GingerGengar/Sizing_Algorithm/CAD UPDATE 10-17/Screen Shot 2022-10-03 at 10.49.30 PM.png

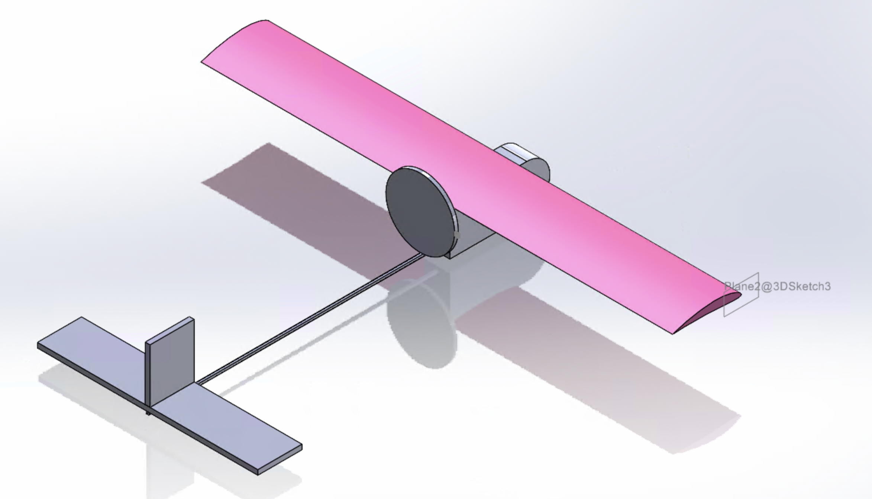
CAD UPDATE 10-17/Screen Shot 2022-10-03 at 10.49.30 PM.png
