GingerGengar/Sizing_Algorithm/CAD Pictures/CG.png

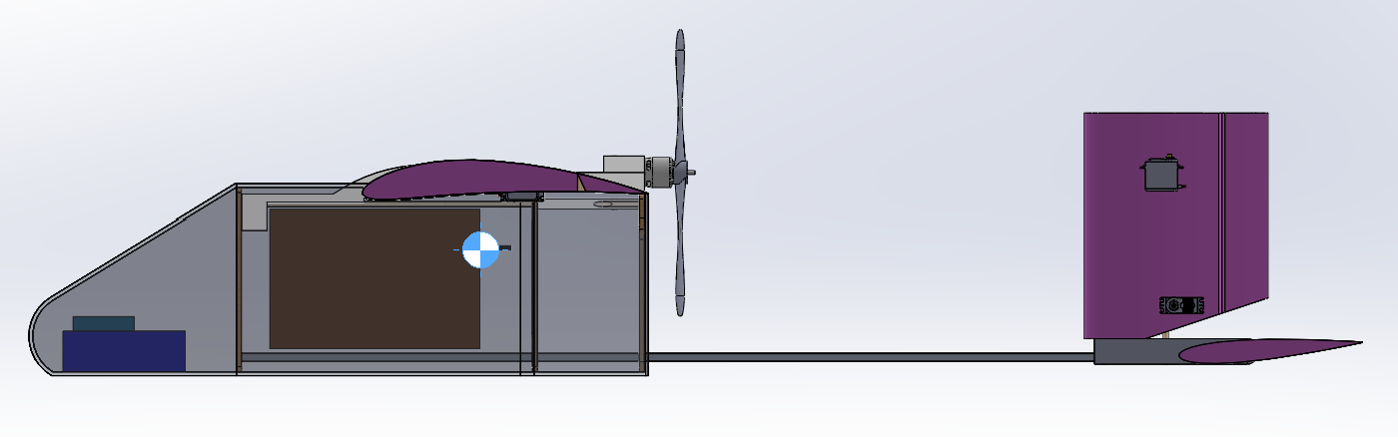
CAD Pictures/CG.png
