GingerGengar/Sizing_Algorithm/README.md

# Purpose of Algorithm

This algorithm is written to estimate the approximate size of an electric vehicle that was tasked of carrying a certain payload.

# Navigating the Code-Base

The Documentation folder contains a PDF document which speaks about the various functionalities and how it intersects well with one another

# Running the Algorithm

This algorithm is mostly written in Matlab. Use Matlab and run it on Main.m . The console and plots appearing are the results of the program.
