GingerGengar/Sizing_Algorithm/Sizing_Algorithm_Code/Documentation/Pre_Amble.tex

\usepackage{amsmath}
\usepackage{esint}
\usepackage{comment}
\usepackage{amssymb}
\usepackage{commath}
\usepackage{geometry}
\usepackage{graphicx}
\usepackage{hyperref}
\usepackage{listings}
\usepackage{xcolor}
\usepackage{array}
\usepackage{float}
\geometry{portrait, margin= 0.5in}
\setcounter{MaxMatrixCols}{30}

\definecolor{codegreen}{rgb}{0,0.6,0}
\definecolor{codegray}{rgb}{0.5,0.5,0.5}
\definecolor{codepurple}{rgb}{0.58,0,0.82}
\definecolor{backcolour}{rgb}{0.95,0.95,0.92}

\lstset{
	columns=fullflexible,
	frame=single,
	breaklines=true,
	backgroundcolor=\color{backcolour},   
	commentstyle=\color{codegreen},
	keywordstyle=\color{magenta},
	numberstyle=\tiny\color{codegray},
	stringstyle=\color{codepurple},
	basicstyle=\ttfamily\footnotesize,
	keepspaces=true,                 
	numbersep=5pt,                  
	showspaces=false,               
	showtabs=false,                  
	tabsize=2
}
