GingerGengar/Sizing_Algorithm/sample_constraint_diagram.png

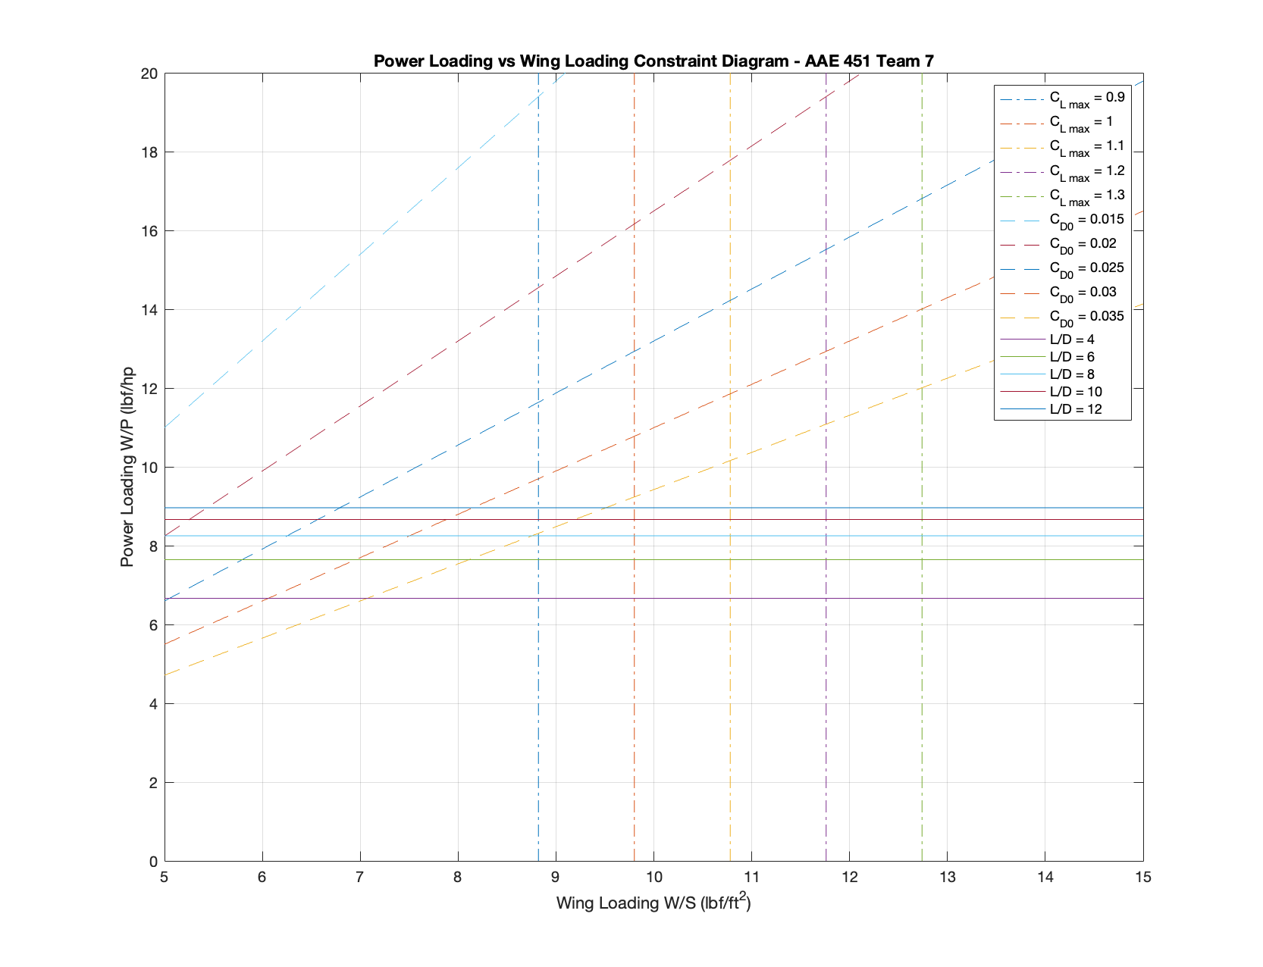
sample_constraint_diagram.png
