GingerGengar/Sizing_Algorithm/CAD UPDATE 10-17/TailAssemblyBetter.SLDASM

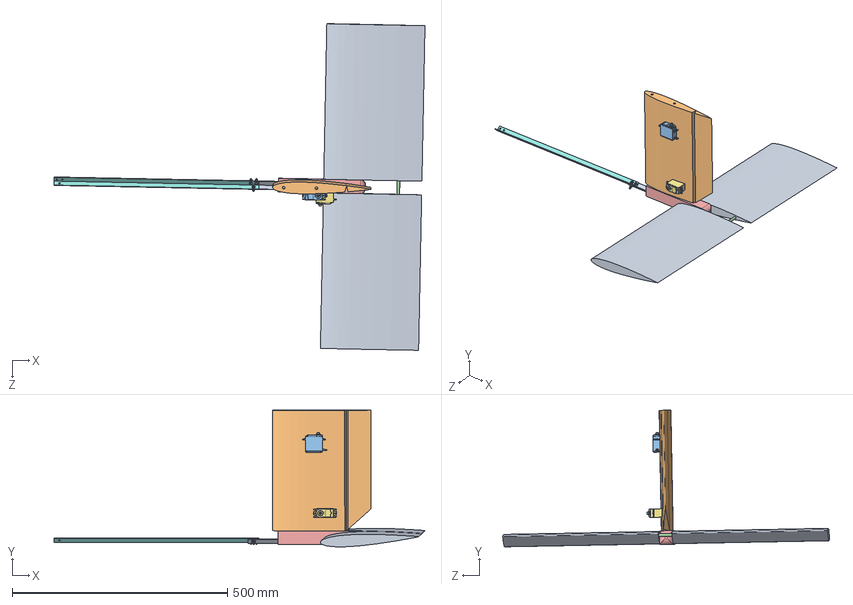
[picture p7: CAD file, 2022-12-03]
CAD UPDATE 10-17/TailAssemblyBetter.SLDASM
861.8 x 317.6 x 758.9 mm
HorizontalTail
VerticalTail
MG995Servo
WoodDowel x 3
TailAdapter
Half_Inch_Spar_CYLINDER_NEW
MG995ServoBig
AngleAluminumMiddle
AngleAluminumEnd
No 8 Pan Head Screw x 3
BoomNut x 3
