GingerGengar/Sizing_Algorithm/CAD UPDATE 10-17/TailAssembly.SLDASM

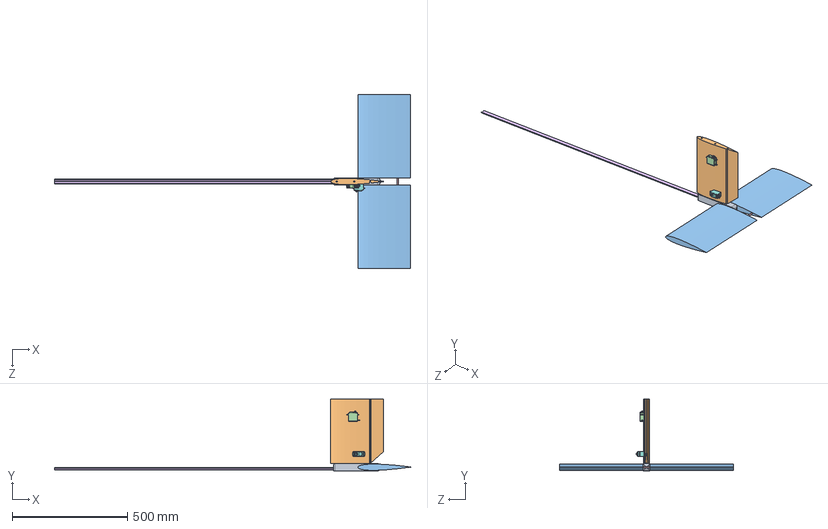
[picture p8: CAD file, 2022-12-03]
CAD UPDATE 10-17/TailAssembly.SLDASM
1546.8 x 311.7 x 754.4 mm
HorizontalTail
VerticalTail
MG995Servo
WoodDowel x 3
AngleAluminum
TailAdapter
Half_Inch_Spar_CYLINDER_NEW
MG995ServoBig
