GingerGengar/Sizing_Algorithm/CAD UPDATE 10-17/StorageAssembly.SLDASM

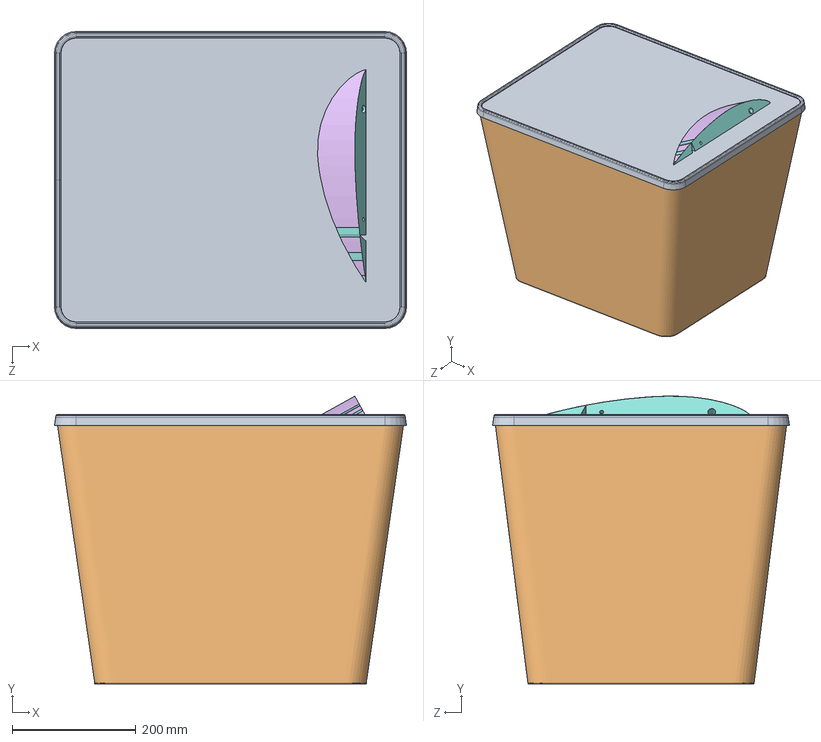
[picture p9: CAD file, 2022-12-03]
CAD UPDATE 10-17/StorageAssembly.SLDASM
568.2 x 464.4 x 479.3 mm
StorageBinBetter
StorageBinLid
BetterWing
WingCenterShell
WingInnerPart x 2
WingOuterShell x 4
WingOuterPart
WingOuterPartLeft
BatteryESCMount
FRONT_WING_MOUNT_NEW
BoomStopper
Motor_Mount_NEW
REAR HARDPOINT
SmallPXMount
TailAdapter
Batt_V1
ESC
Pixhawk_V1
Propellar
Motor
MotorX
FuselageBackRibANGLE_NEW
FuselageFrontRibANGLE_NEW
FuselageMiddleRibANGLE_NEW
HorizontalTailSplit x 2
VerticalTail
WoodDowel x 7
Half_Inch_Spar x 5
AngleAluminumEnd
AngleAluminumFront
AngleAluminumMiddle
FuselageDowel x 2
No 8 Pan Head Screw x 9
BoomNut x 9
NylonBoltHex x 2
NylonNut x 2
