GingerGengar/Sizing_Algorithm/CAD UPDATE 10-17/WingAssembly.SLDASM

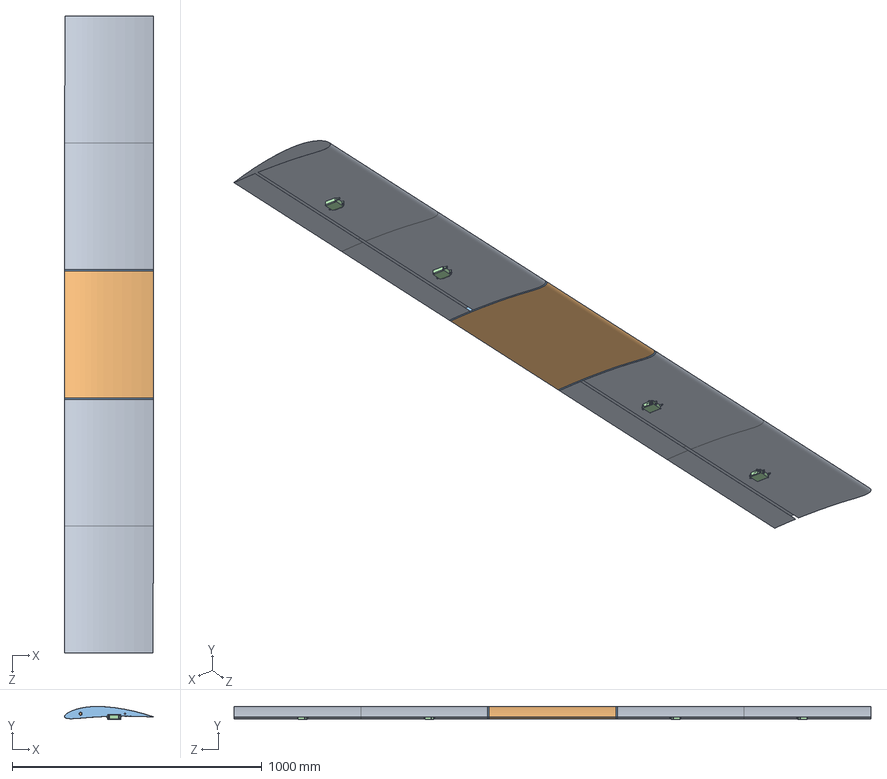
[picture p10: CAD file, 2022-12-03]
CAD UPDATE 10-17/WingAssembly.SLDASM
357.4 x 52.6 x 2552.9 mm
BetterWing
WingConnector x 2
MG995Servo x 4
WingOuterShell x 4
Half_Inch_Spar_CYLINDER_NEW x 4
WoodDowel x 4
