GingerGengar/Sizing_Algorithm/CAD UPDATE 10-17/BatteryRemoval.SLDASM

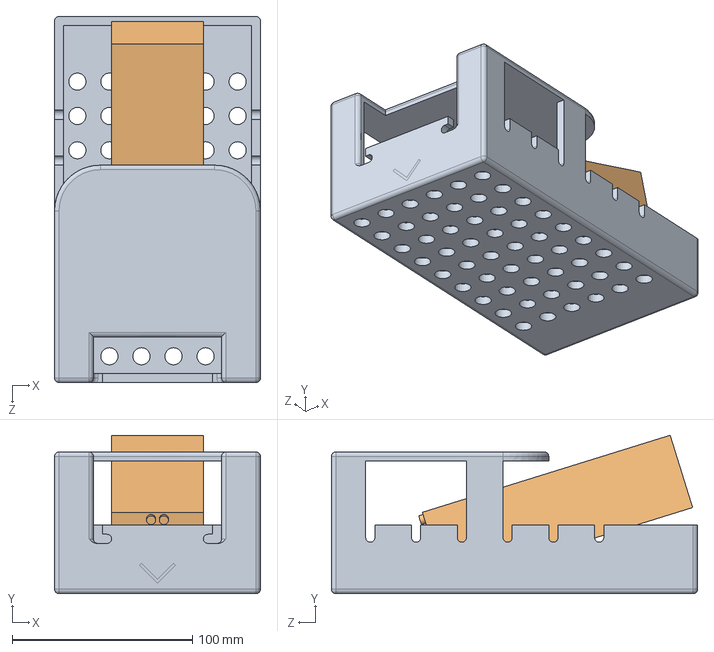
[picture p11: CAD file, 2022-12-03]
CAD UPDATE 10-17/BatteryRemoval.SLDASM
114.3 x 87.9 x 203.2 mm
BatteryESCMount
Batt_V1
