GingerGengar/Sizing_Algorithm/CAD UPDATE 10-17/AssemblyGoCrazy.SLDASM

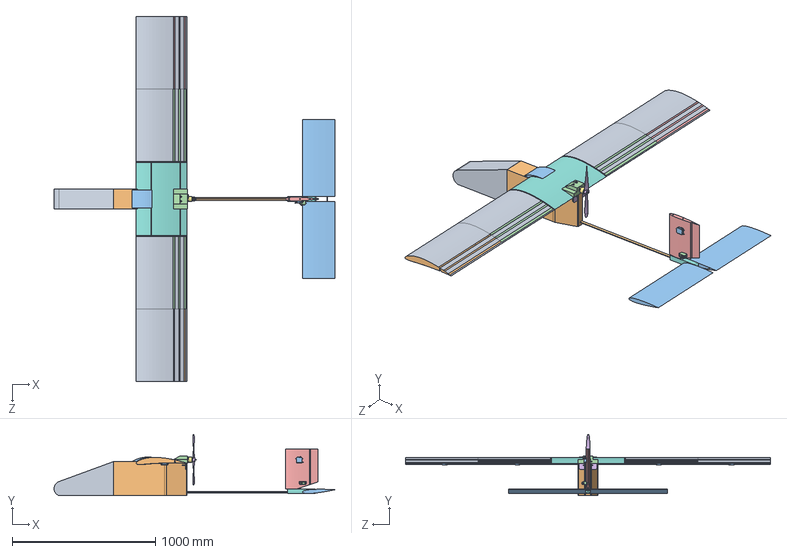
[picture p12: CAD file, 2022-10-29]
CAD UPDATE 10-17/AssemblyGoCrazy.SLDASM
1963.2 x 428.6 x 2552.7 mm
HorizontalTail
FuselageWithWingShape
BetterWing
VerticalTail
Propellar
Motor
Batt_V1
Big_Payload
Pixhawk_V1
MG995Servo x 5
WingInnerPart x 2
WingOuterPart
WingConnector x 2
WoodDowel x 7
WingCenterShell
WingOuterShell x 4
AngleAluminum
FRONT_WING_MOUNT_NEW
Motor_Mount_NEW
REAR HARDPOINT
FuselageBackRibANGLE_NEW
FuselageFrontRibANGLE_NEW
TailAdapter
Half_Inch_Spar_CYLINDER_NEW x 5
WingOuterPartLeft
ESC
MG995ServoBig
FuselageMiddleRibANGLE_NEW
FuselageDowel x 2
CrazyNoze
