GingerGengar/Sizing_Algorithm/CAD UPDATE 10-17/BetterAssembly.SLDASM

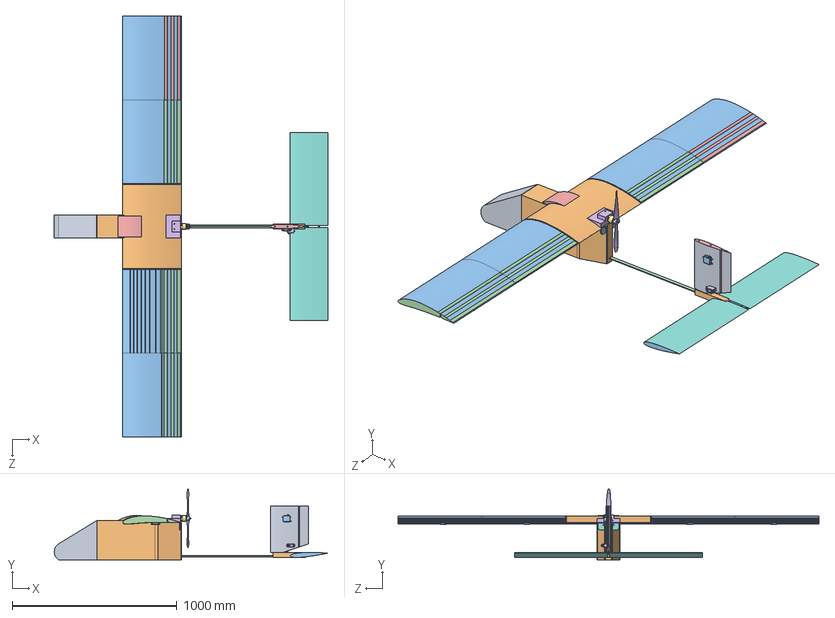
[picture p13: CAD file, 2022-10-26]
CAD UPDATE 10-17/BetterAssembly.SLDASM
1658.7 x 429.7 x 2552.7 mm
HorizontalTail
FuselageWithWingShape
BetterWing
VerticalTail
Propellar
Motor
Batt_V1
Big_Payload
Pixhawk_V1
MG995Servo x 5
WingInnerPart x 2
WingOuterPart
WingConnector x 2
WoodDowel x 7
WingCenterShell
WingOuterShell x 4
AngleAluminum
FRONT_WING_MOUNT_NEW
Motor_Mount_NEW
REAR HARDPOINT
FuselageBackRibANGLE_NEW
FuselageFrontRibANGLE_NEW
TailAdapter
Half_Inch_Spar_CYLINDER_NEW x 5
WingOuterPartLeft
ESC
MG995ServoBig
FuselageMiddleRibANGLE_NEW
NoseCone
