GingerGengar/Sizing_Algorithm/CAD UPDATE 10-17/Assembly.SLDASM

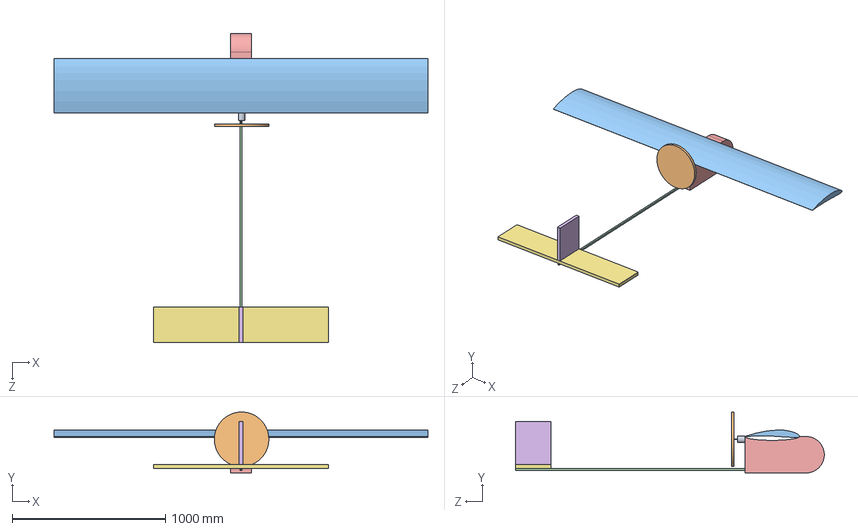
[picture p15: CAD file, 2022-10-04]
CAD UPDATE 10-17/Assembly.SLDASM
2438.4 x 397.4 x 2011.7 mm
Motor_V1
Prop_V1
Wing V1
CF_Rod_V1
Fuselage_V1
Rudder_FlatPlate_V1
Stabilator_FlatPlate_V1
