GingerGengar/Sizing_Algorithm/CAD UPDATE 10-17/Pixhawk_V1.SLDPRT

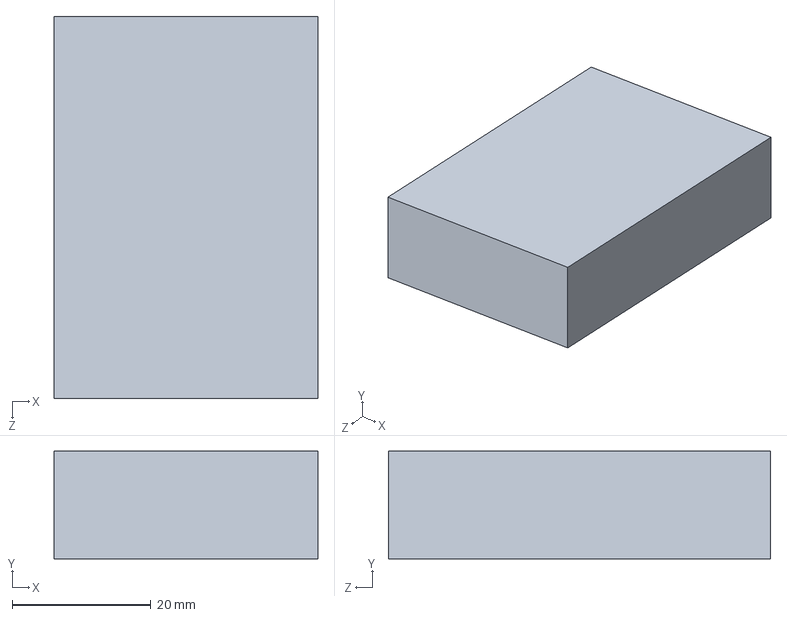
[picture p16: CAD file, 2022-12-03]
CAD UPDATE 10-17/Pixhawk_V1.SLDPRT
38.0 x 15.5 x 55.0 mm
