GingerGengar/Sizing_Algorithm/STL 10-27-22/TailAdapter.STL

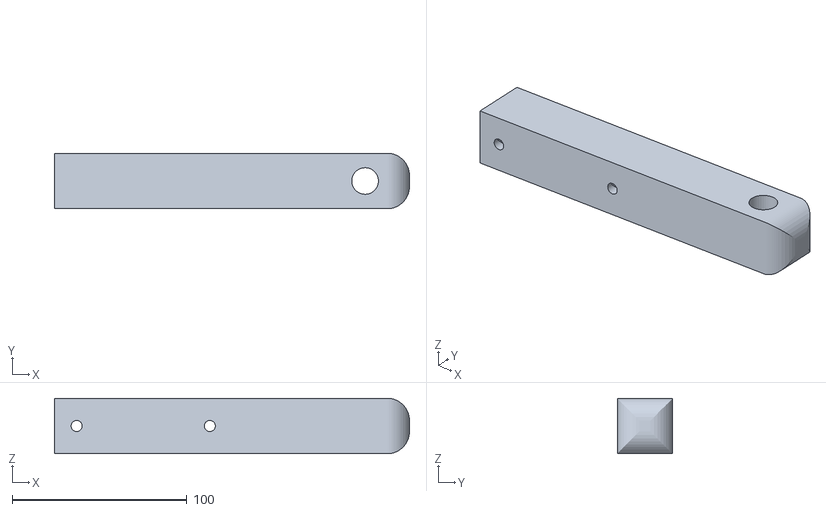
[picture p17: CAD file, 2022-12-03]
STL 10-27-22/TailAdapter.STL
203.2 x 31.8 x 31.8
