GingerGengar/Sizing_Algorithm/STL 11-3-22/FRONT_WING_MOUNT_NEW.STL

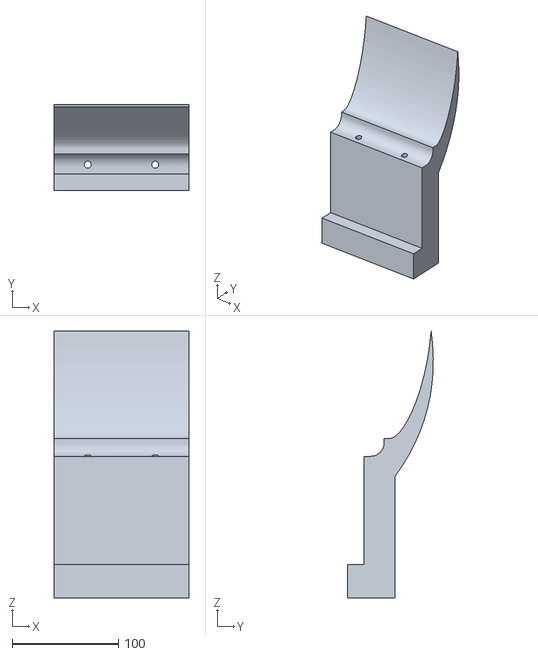
[picture p18: CAD file, 2022-12-03]
STL 11-3-22/FRONT_WING_MOUNT_NEW.STL
127.0 x 80.5 x 251.3
