GingerGengar/Sizing_Algorithm/STL/Half_Inch_Spar_CYLINDER_NEW.STL

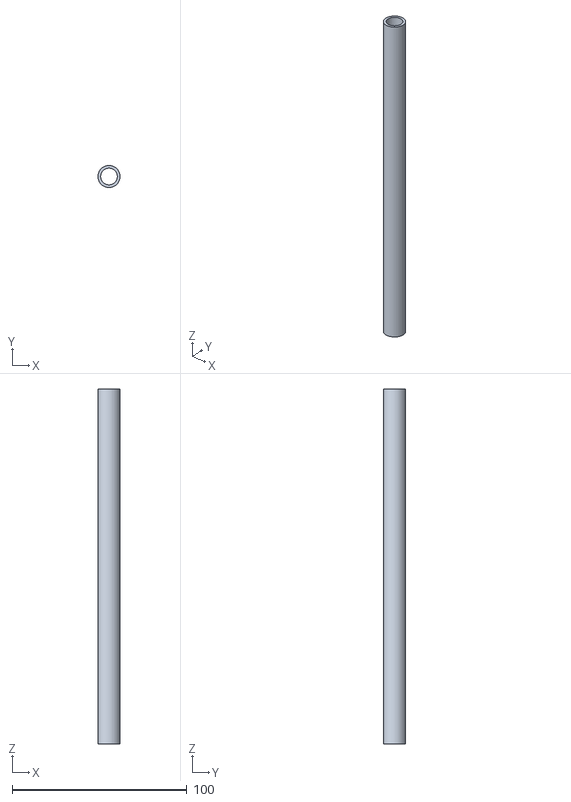
[picture p19: CAD file, 2022-10-18]
STL/Half_Inch_Spar_CYLINDER_NEW.STL
12.7 x 12.7 x 203.2
