GingerGengar/Sizing_Algorithm/STL 10-27-22/BoomStopper.STL

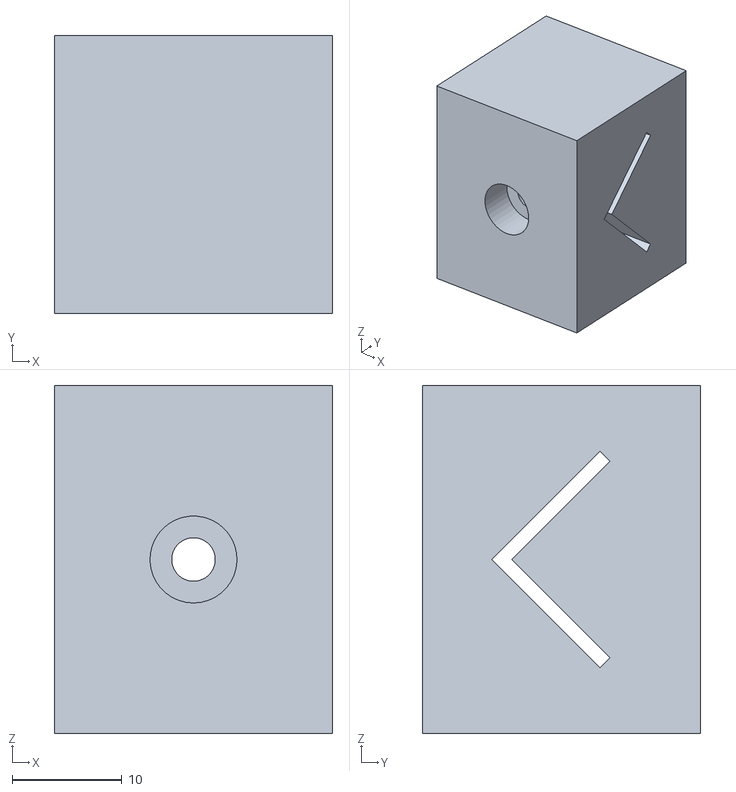
[picture p20: CAD file, 2022-12-03]
STL 10-27-22/BoomStopper.STL
25.4 x 25.4 x 31.8
