GingerGengar/Sizing_Algorithm/STL 11-3-22/SmallPXMount_TOLERANCE.STL

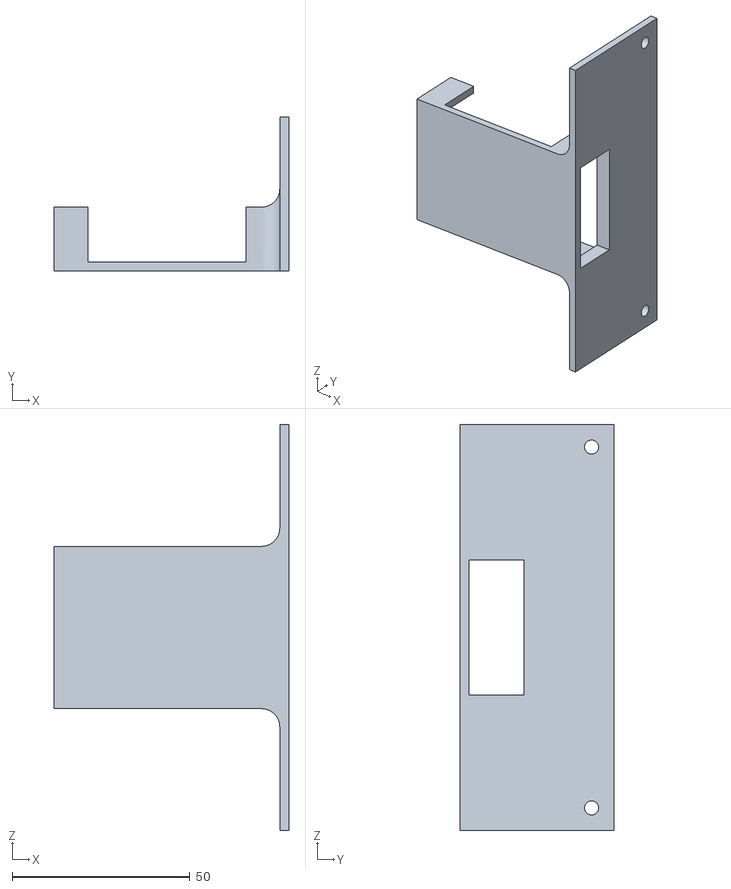
[picture p21: CAD file, 2022-12-03]
STL 11-3-22/SmallPXMount_TOLERANCE.STL
66.0 x 43.4 x 114.3
