GingerGengar/Sizing_Algorithm/CAD UPDATE 10-17/BigPXMount.SLDPRT

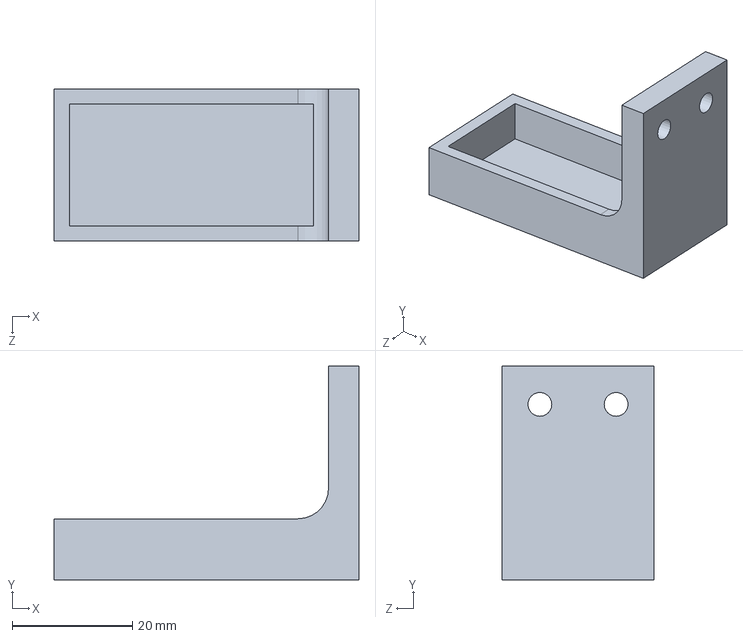
[picture p22: CAD file, 2022-12-03]
CAD UPDATE 10-17/BigPXMount.SLDPRT
50.8 x 35.6 x 25.4 mm
