GingerGengar/Sizing_Algorithm/STL 10-27-22/BatteryESCMount.STL

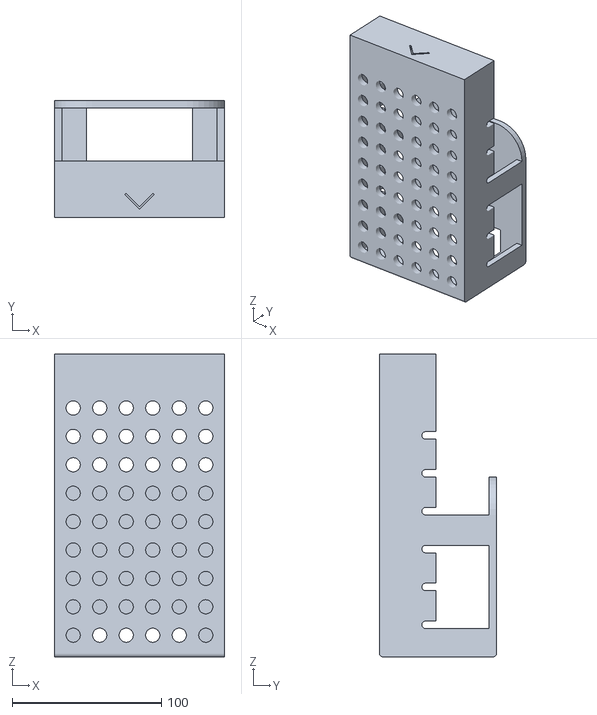
[picture p23: CAD file, 2022-12-03]
STL 10-27-22/BatteryESCMount.STL
114.3 x 78.7 x 203.2
