GingerGengar/Sizing_Algorithm/STL 11-3-22/SmallPXMount.STL

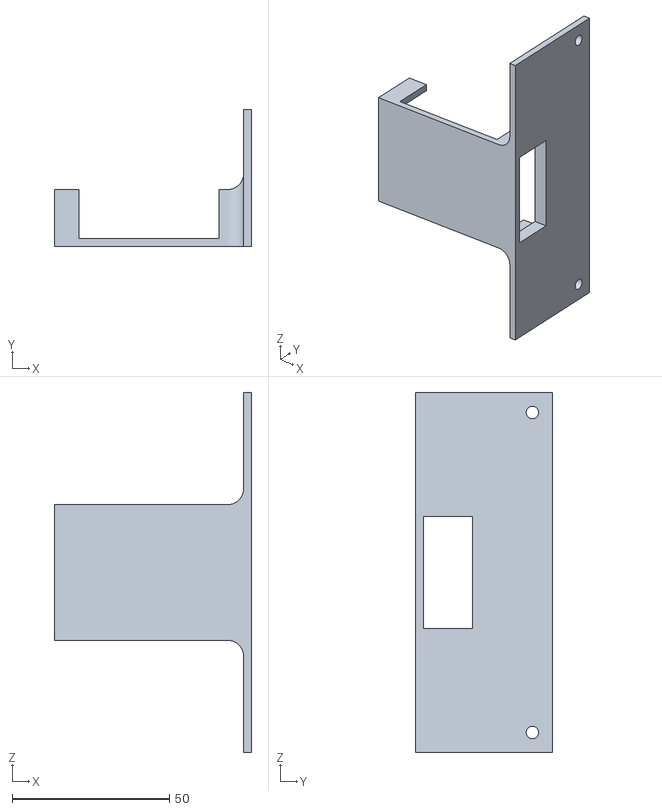
[picture p24: CAD file, 2022-12-03]
STL 11-3-22/SmallPXMount.STL
62.6 x 43.4 x 114.3
