GingerGengar/Sizing_Algorithm/CAD UPDATE 10-17/WingOuterShell.SLDPRT

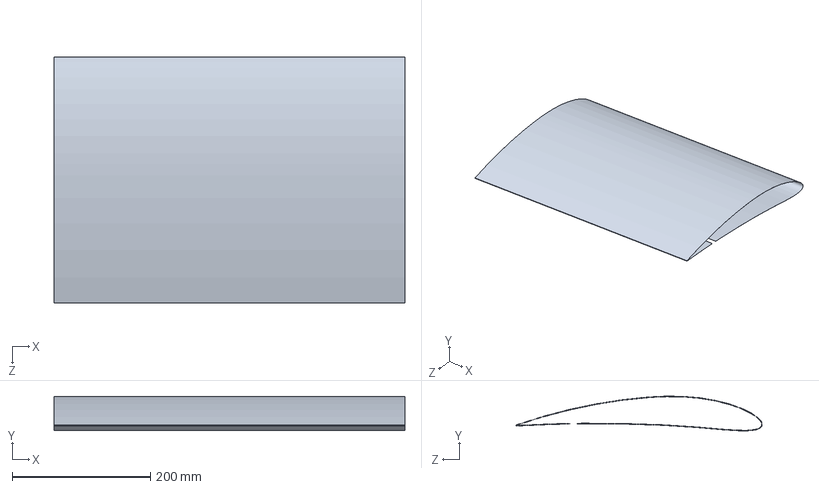
[picture p25: CAD file, 2022-12-03]
CAD UPDATE 10-17/WingOuterShell.SLDPRT
508.0 x 49.4 x 355.9 mm
