GingerGengar/Sizing_Algorithm/STL 11-3-22/Motor_Mount_NEW.STL

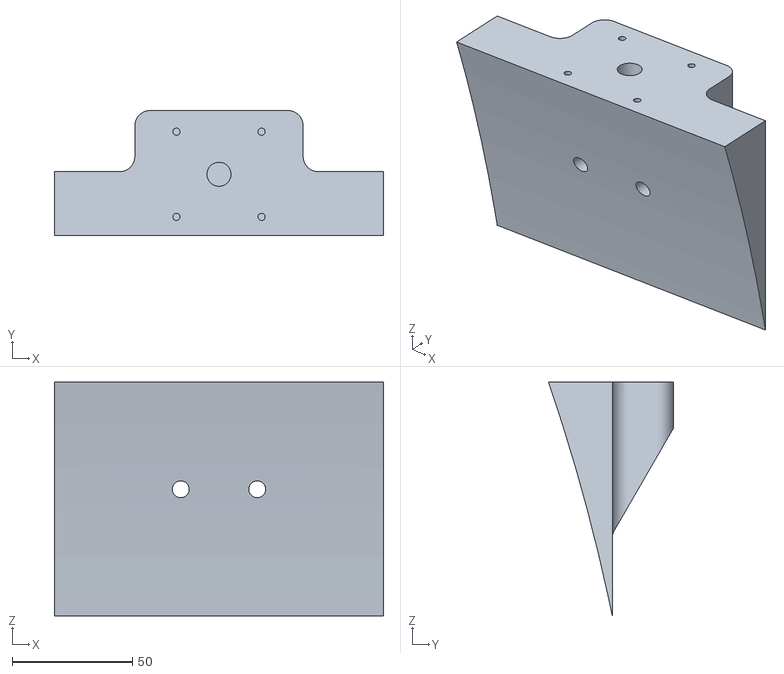
[picture p26: CAD file, 2022-12-03]
STL 11-3-22/Motor_Mount_NEW.STL
136.5 x 51.9 x 96.9
