GingerGengar/Sizing_Algorithm/CAD UPDATE 10-17/XT60 FEMALE.SLDPRT

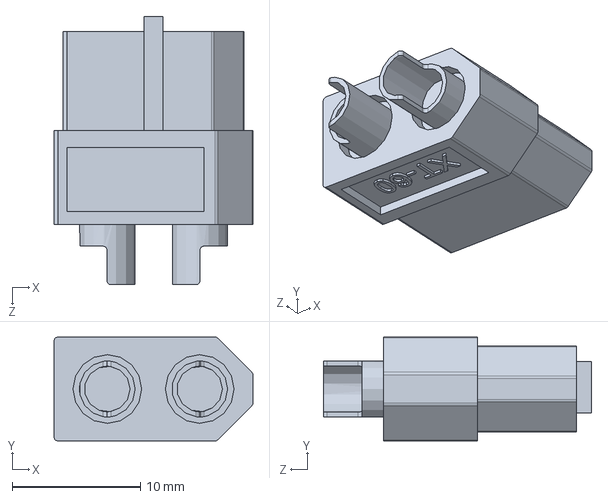
[picture p27: CAD file, 2022-12-03]
CAD UPDATE 10-17/XT60 FEMALE.SLDPRT
15.5 x 8.10 x 20.9 mm
