GingerGengar/Sizing_Algorithm/CAD UPDATE 10-17/MotorX.SLDPRT

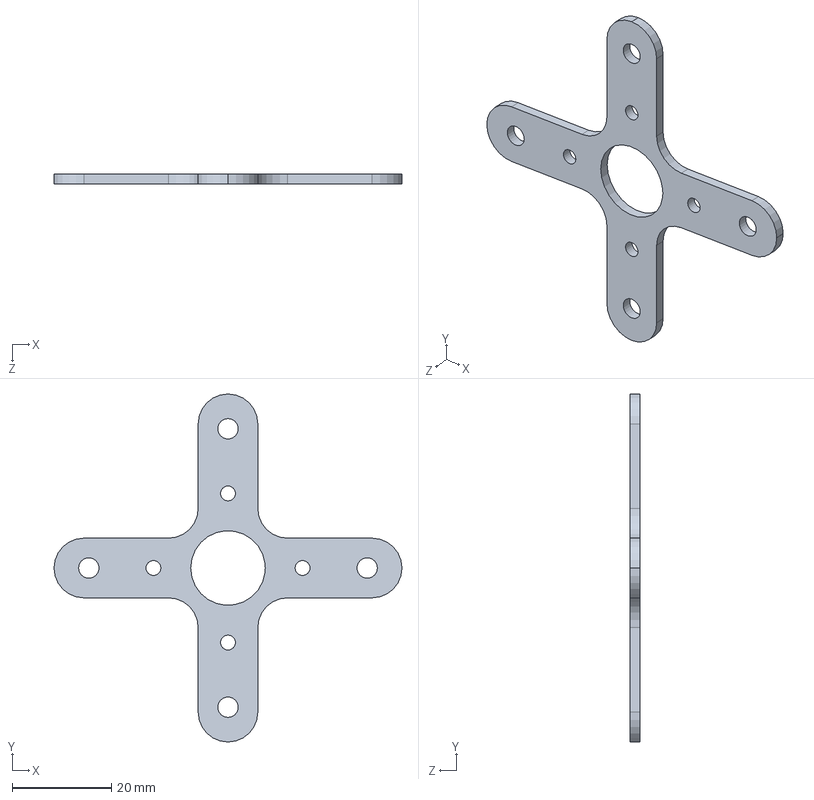
[picture p28: CAD file, 2022-12-03]
CAD UPDATE 10-17/MotorX.SLDPRT
70.0 x 70.0 x 2.00 mm
