GingerGengar/Sizing_Algorithm/STL 10-27-22/Motor_Mount_NEW.STL

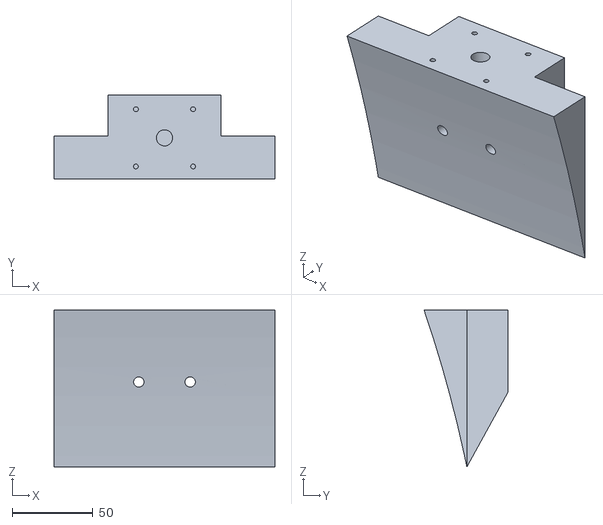
[picture p29: CAD file, 2022-10-29]
STL 10-27-22/Motor_Mount_NEW.STL
136.5 x 51.9 x 96.9
