GingerGengar/Sizing_Algorithm/STL 11-3-22/REAR HARDPOINT.STL

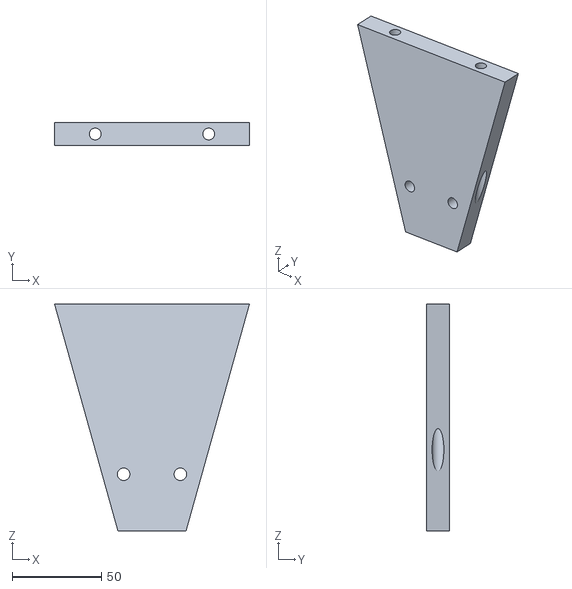
[picture p30: CAD file, 2022-12-03]
STL 11-3-22/REAR HARDPOINT.STL
109.1 x 12.7 x 127.0
