GingerGengar/Sizing_Algorithm/CAD UPDATE 10-17/StorageBinLid.SLDPRT

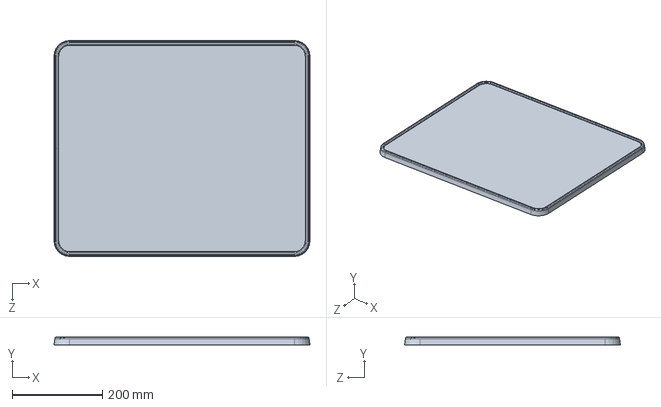
[picture p31: CAD file, 2022-12-03]
CAD UPDATE 10-17/StorageBinLid.SLDPRT
568.2 x 17.8 x 479.3 mm
