GingerGengar/Sizing_Algorithm/STL 11-3-22/BoomStopper.STL

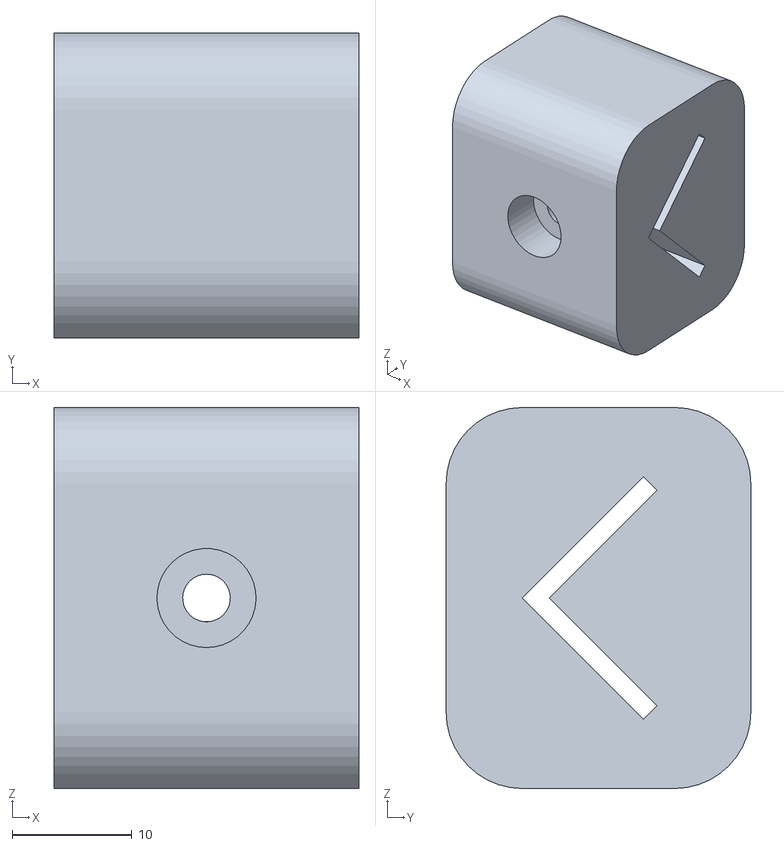
[picture p32: CAD file, 2022-12-03]
STL 11-3-22/BoomStopper.STL
25.4 x 25.4 x 31.8
