GingerGengar/Sizing_Algorithm/CAD UPDATE 10-17/NoseCone.SLDPRT

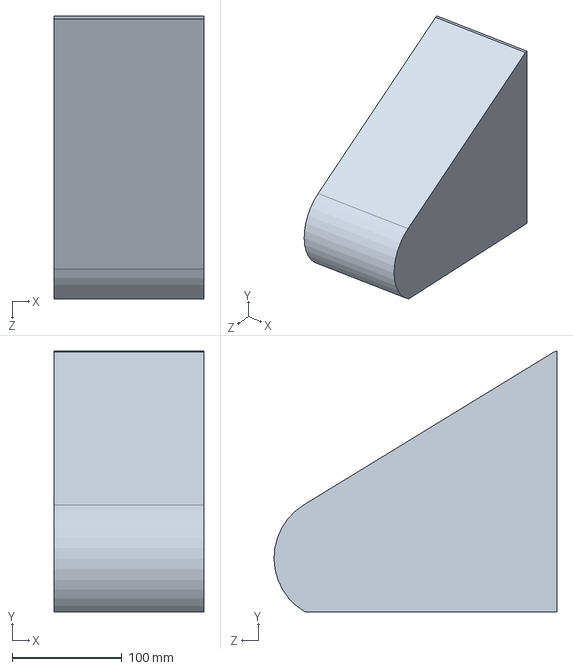
[picture p33: CAD file, 2022-12-03]
CAD UPDATE 10-17/NoseCone.SLDPRT
136.7 x 238.3 x 258.4 mm
