GingerGengar/Sizing_Algorithm/CAD UPDATE 10-17/Motor.SLDPRT

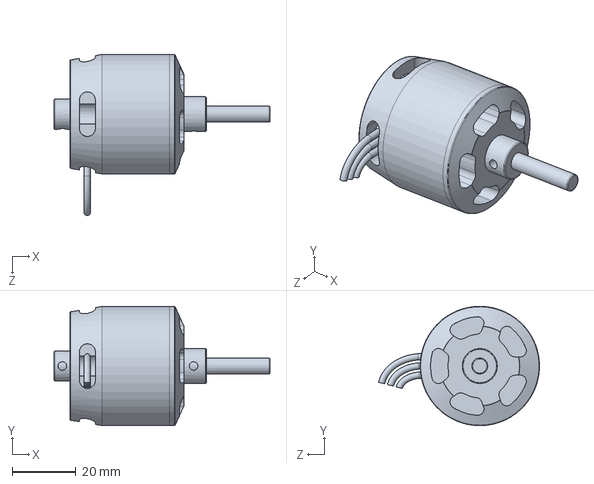
[picture p34: CAD file, 2022-12-03]
CAD UPDATE 10-17/Motor.SLDPRT
67.8 x 37.5 x 50.6 mm
