GingerGengar/Sizing_Algorithm/CAD UPDATE 10-17/FRONT_WING_MOUNT_NEW.SLDPRT

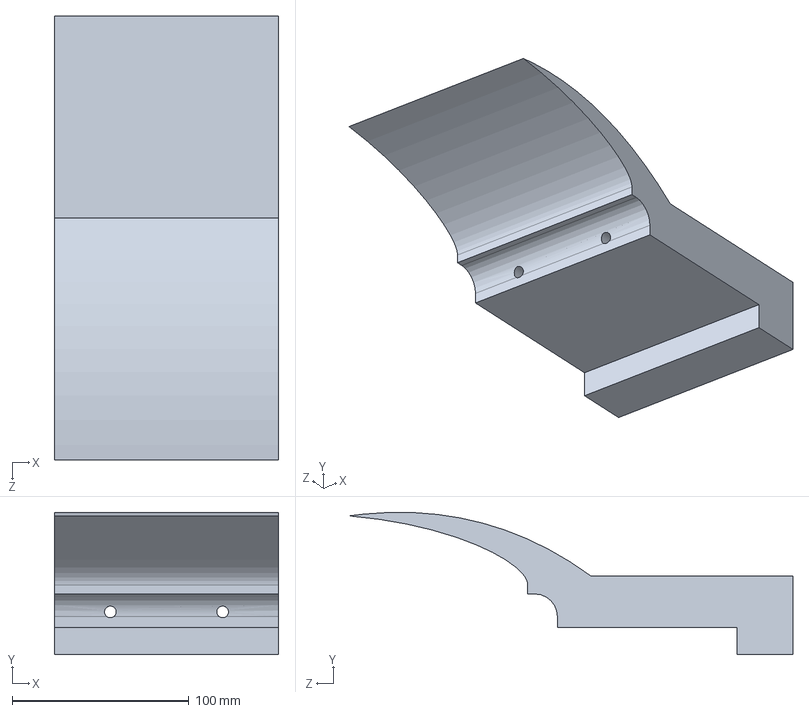
[picture p35: CAD file, 2022-12-03]
CAD UPDATE 10-17/FRONT_WING_MOUNT_NEW.SLDPRT
127.0 x 80.4 x 251.3 mm
