GingerGengar/Sizing_Algorithm/CAD UPDATE 10-17/ESC.SLDPRT

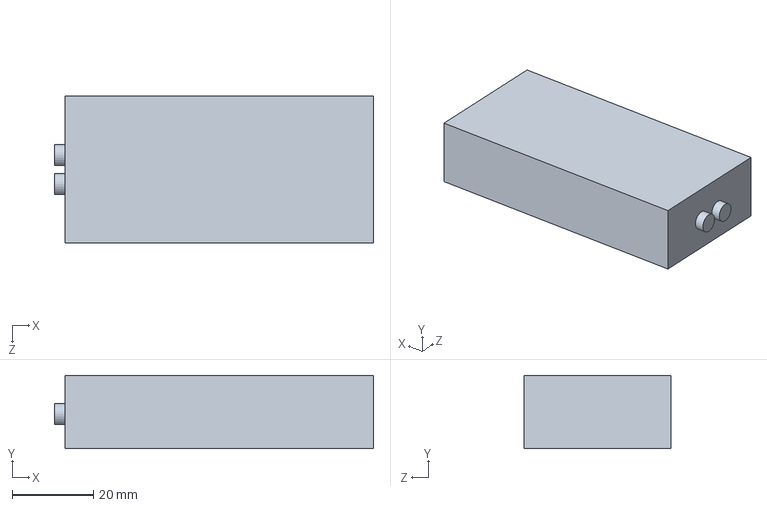
[picture p36: CAD file, 2022-12-03]
CAD UPDATE 10-17/ESC.SLDPRT
78.5 x 18.0 x 36.1 mm
