GingerGengar/Sizing_Algorithm/CAD UPDATE 10-17/Batt_V1.SLDPRT

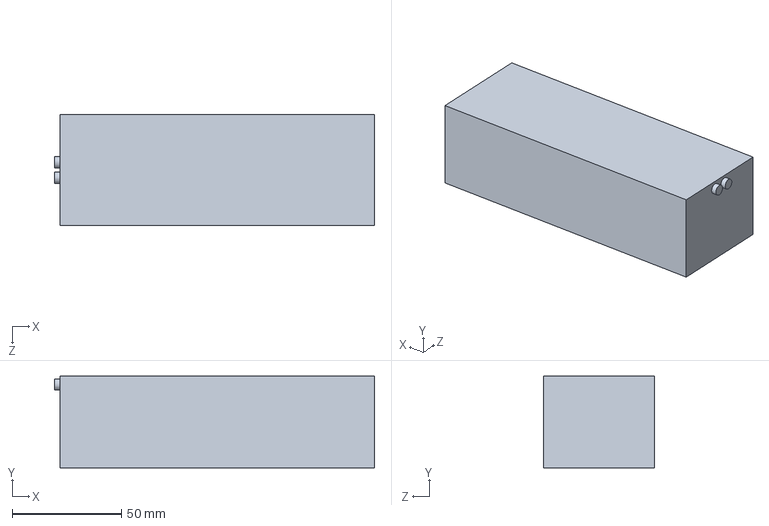
[picture p37: CAD file, 2022-12-03]
CAD UPDATE 10-17/Batt_V1.SLDPRT
146.5 x 42.0 x 51.0 mm
