GingerGengar/Sizing_Algorithm/CAD UPDATE 10-17/FuselageMiddleRibANGLE_NEW.SLDPRT

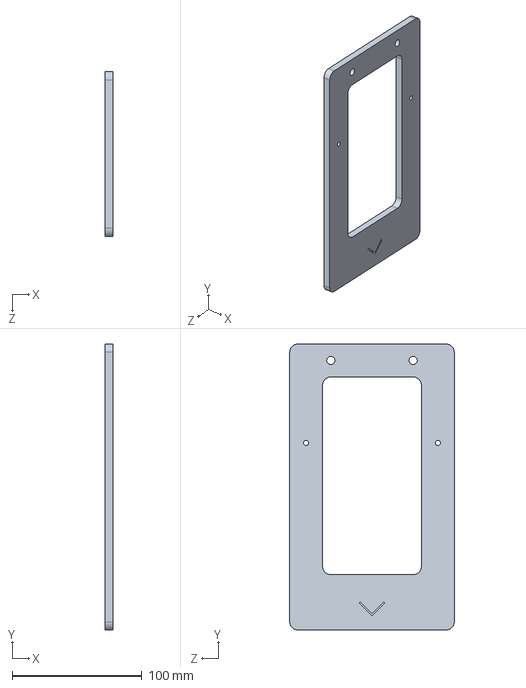
[picture p38: CAD file, 2022-12-03]
CAD UPDATE 10-17/FuselageMiddleRibANGLE_NEW.SLDPRT
6.35 x 220.5 x 127.0 mm
