GingerGengar/Sizing_Algorithm/CAD UPDATE 10-17/FuselageFrontRibANGLE_NEW.SLDPRT

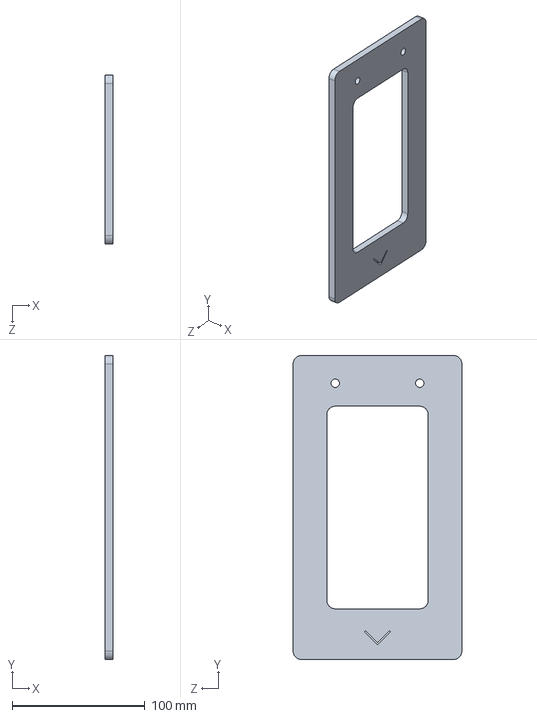
[picture p39: CAD file, 2022-12-03]
CAD UPDATE 10-17/FuselageFrontRibANGLE_NEW.SLDPRT
6.35 x 228.6 x 127.0 mm
