GingerGengar/Sizing_Algorithm/CAD UPDATE 10-17/StorageBin.SLDPRT

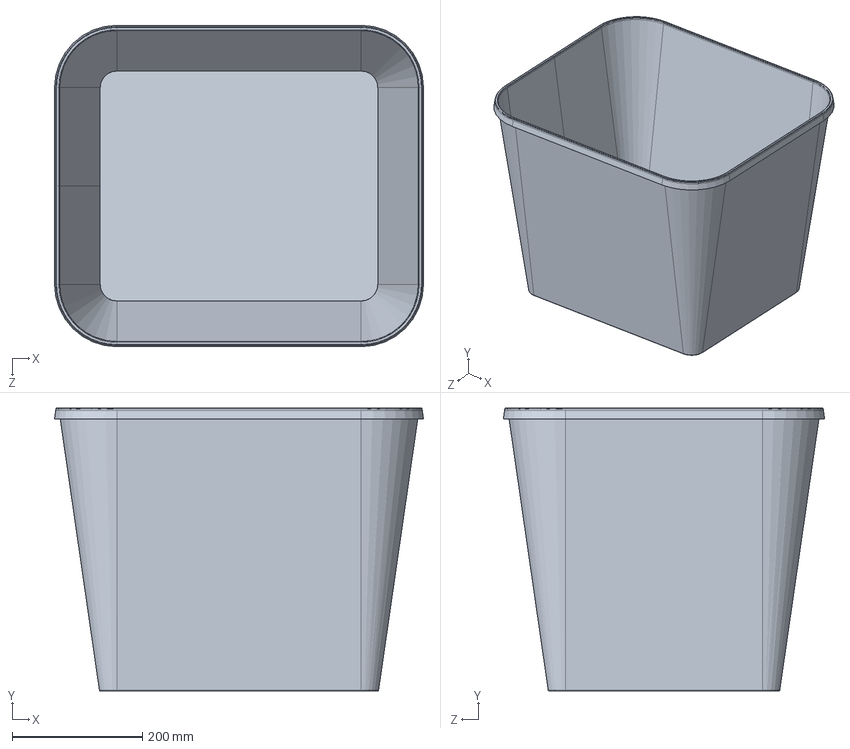
[picture p40: CAD file, 2022-12-03]
CAD UPDATE 10-17/StorageBin.SLDPRT
565.6 x 433.7 x 492.6 mm
