GingerGengar/Sizing_Algorithm/CAD UPDATE 10-17/FuselageDoor.SLDPRT

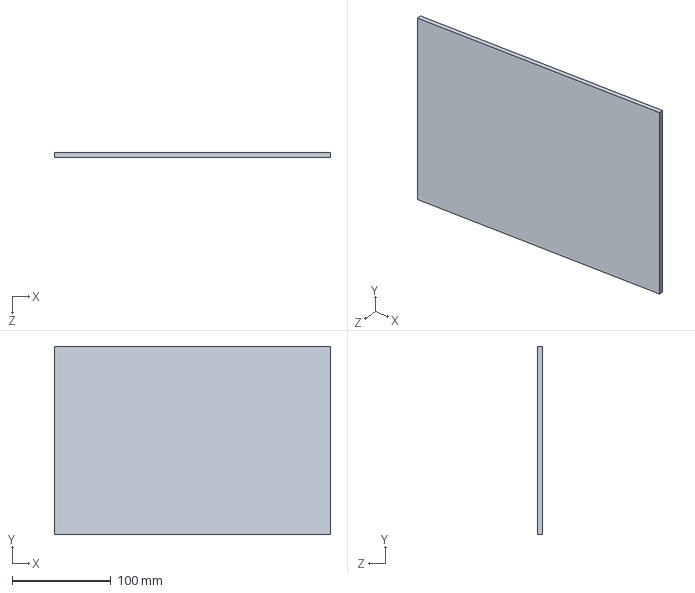
[picture p41: CAD file, 2022-12-03]
CAD UPDATE 10-17/FuselageDoor.SLDPRT
279.4 x 190.5 x 4.83 mm
