GingerGengar/Sizing_Algorithm/CAD UPDATE 10-17/AngleAluminumEnd.SLDPRT

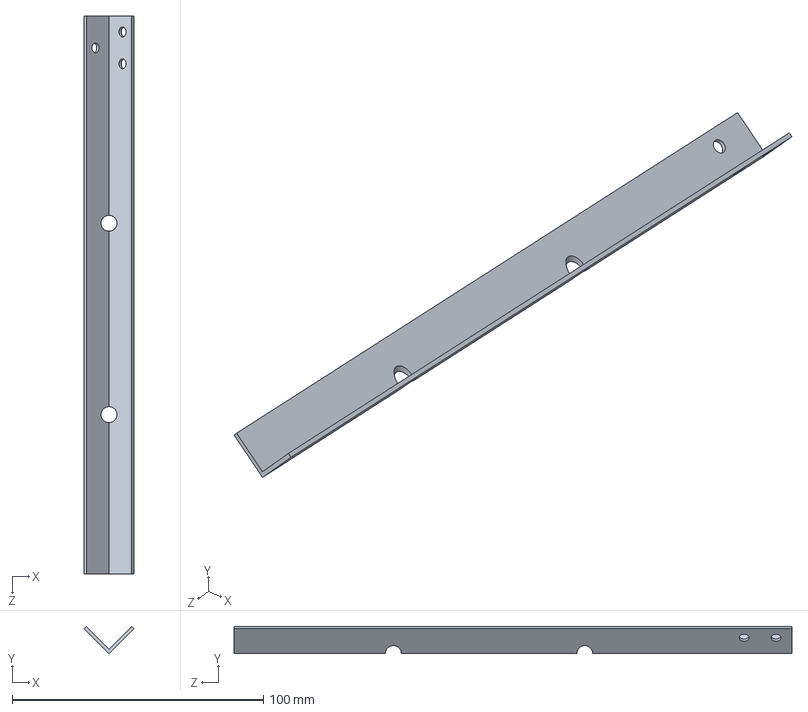
[picture p42: CAD file, 2022-12-03]
CAD UPDATE 10-17/AngleAluminumEnd.SLDPRT
19.8 x 10.8 x 222.2 mm
