GingerGengar/Sizing_Algorithm/CAD UPDATE 10-17/AngleAluminumFront.SLDPRT

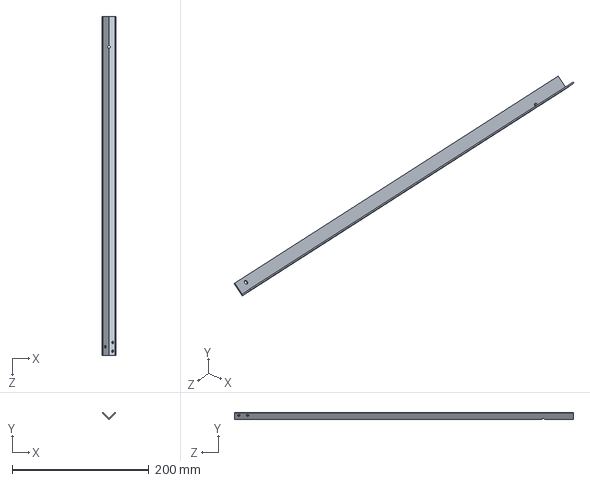
[picture p43: CAD file, 2022-12-03]
CAD UPDATE 10-17/AngleAluminumFront.SLDPRT
19.8 x 10.8 x 495.3 mm
