GingerGengar/Sizing_Algorithm/CAD UPDATE 10-17/HorizontalTail.SLDPRT

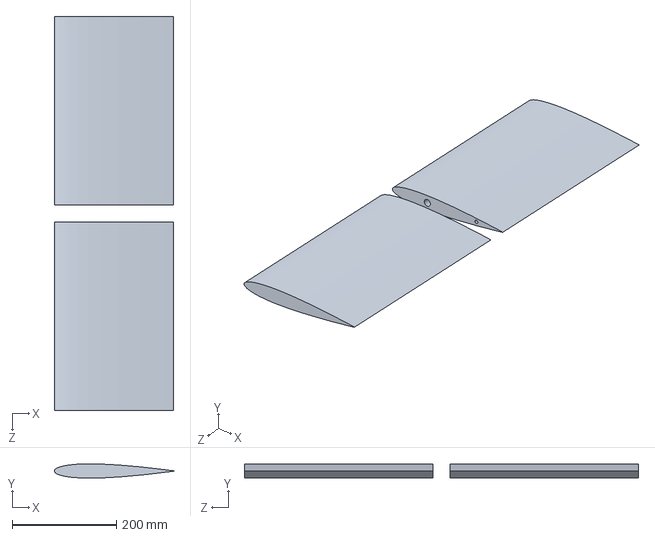
[picture p44: CAD file, 2022-12-03]
CAD UPDATE 10-17/HorizontalTail.SLDPRT
228.6 x 27.4 x 754.4 mm
