GingerGengar/Sizing_Algorithm/CAD UPDATE 10-17/VerticalTail.SLDPRT

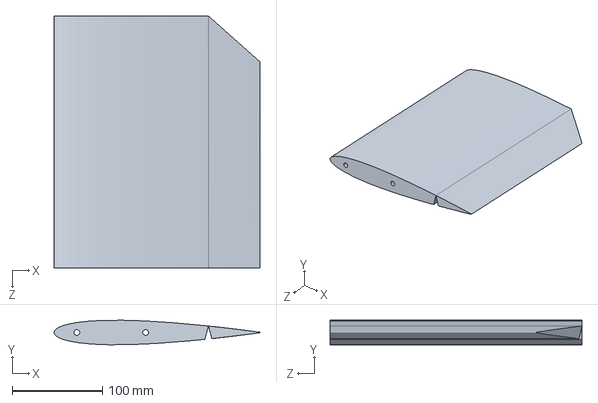
[picture p45: CAD file, 2022-12-03]
CAD UPDATE 10-17/VerticalTail.SLDPRT
228.6 x 27.3 x 279.9 mm
