GingerGengar/Sizing_Algorithm/CAD UPDATE 10-17/HorizontalTailSplit.SLDPRT

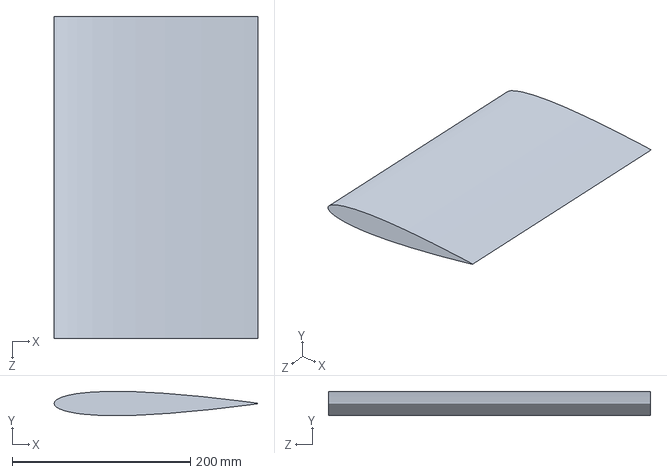
[picture p46: CAD file, 2022-12-03]
CAD UPDATE 10-17/HorizontalTailSplit.SLDPRT
228.6 x 27.4 x 361.4 mm
