GingerGengar/Sizing_Algorithm/CAD UPDATE 10-17/AngleAluminumMiddle.SLDPRT

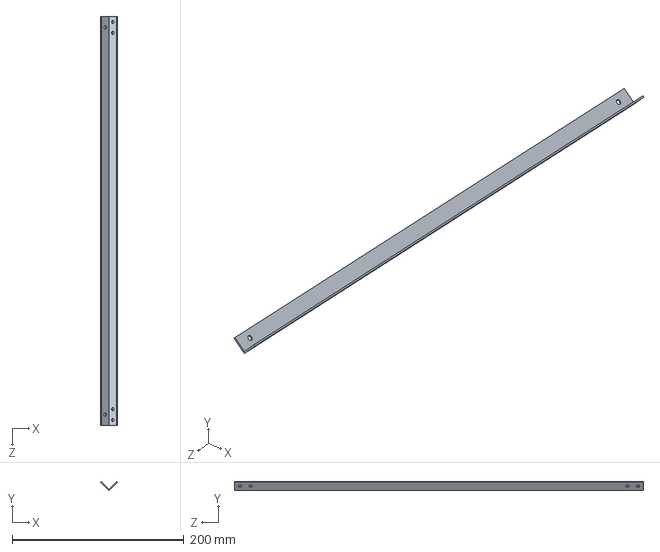
[picture p47: CAD file, 2022-12-03]
CAD UPDATE 10-17/AngleAluminumMiddle.SLDPRT
19.8 x 10.8 x 476.2 mm
