GingerGengar/Sizing_Algorithm/CAD UPDATE 10-17/BoomNut.SLDPRT

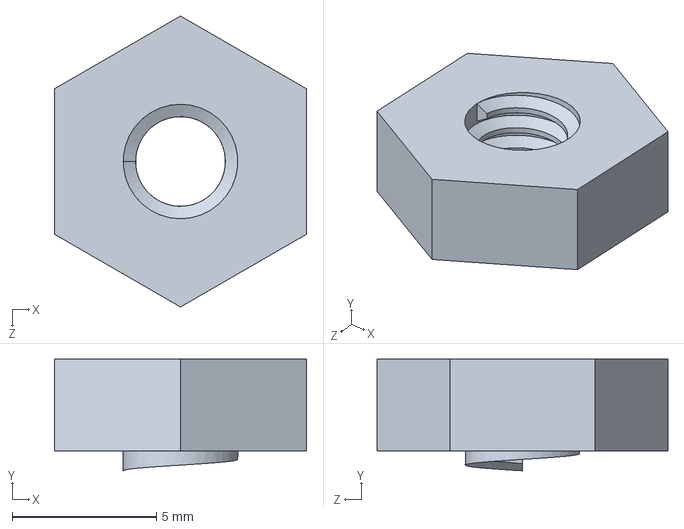
[picture p48: CAD file, 2022-12-03]
CAD UPDATE 10-17/BoomNut.SLDPRT
8.73 x 3.87 x 10.1 mm
