GingerGengar/Sizing_Algorithm/CAD UPDATE 10-17/Motor_Mount_NEW.SLDPRT

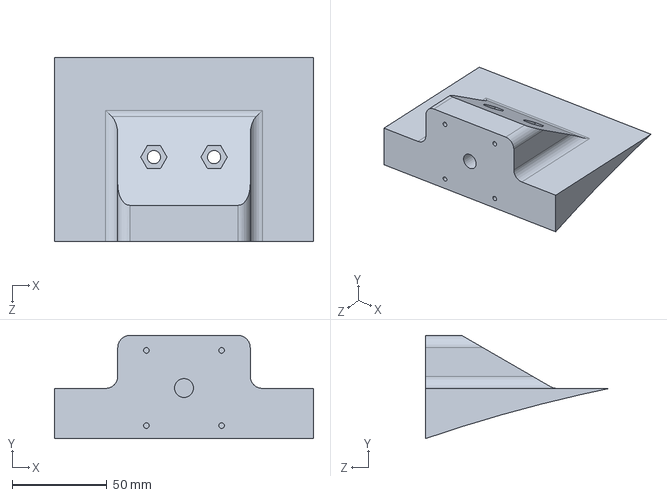
[picture p49: CAD file, 2022-12-03]
CAD UPDATE 10-17/Motor_Mount_NEW.SLDPRT
136.5 x 54.4 x 96.9 mm
