GingerGengar/Sizing_Algorithm/CAD UPDATE 10-17/StorageBinBetter.SLDPRT

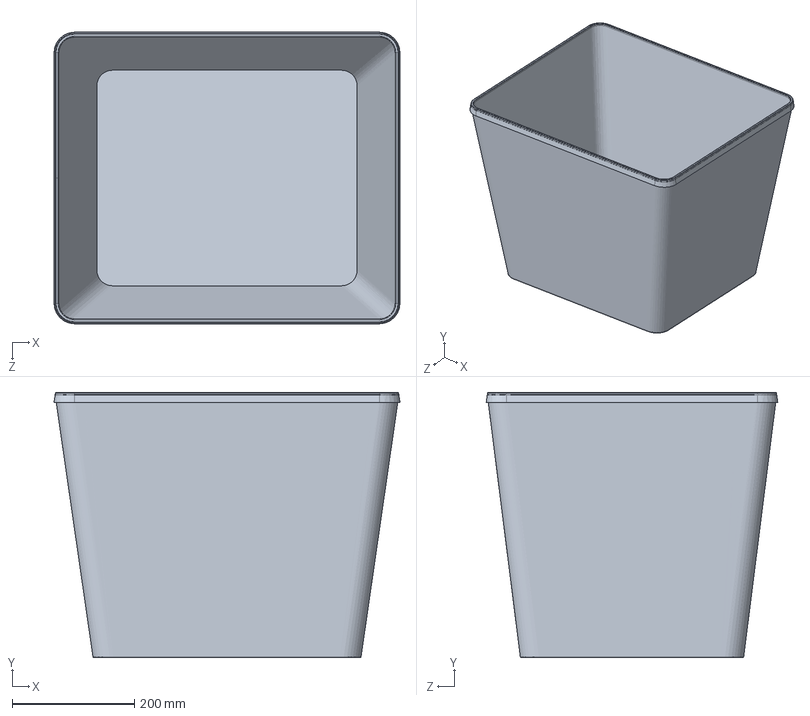
[picture p50: CAD file, 2022-12-03]
CAD UPDATE 10-17/StorageBinBetter.SLDPRT
565.6 x 433.7 x 476.7 mm
