GingerGengar/Sizing_Algorithm/CAD UPDATE 10-17/XT60 MALE.SLDPRT

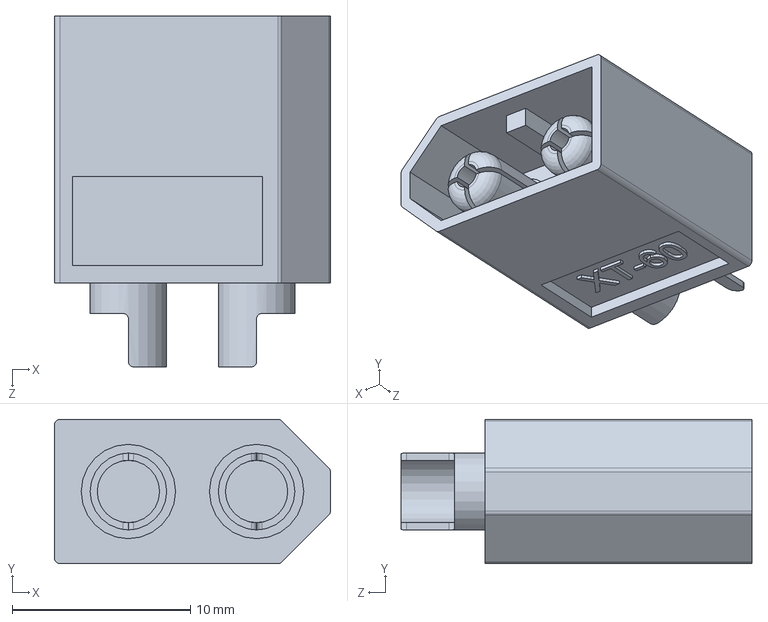
[picture p51: CAD file, 2022-12-03]
CAD UPDATE 10-17/XT60 MALE.SLDPRT
15.5 x 8.10 x 19.7 mm
