GingerGengar/Sizing_Algorithm/CAD UPDATE 10-17/AngleAluminum.SLDPRT

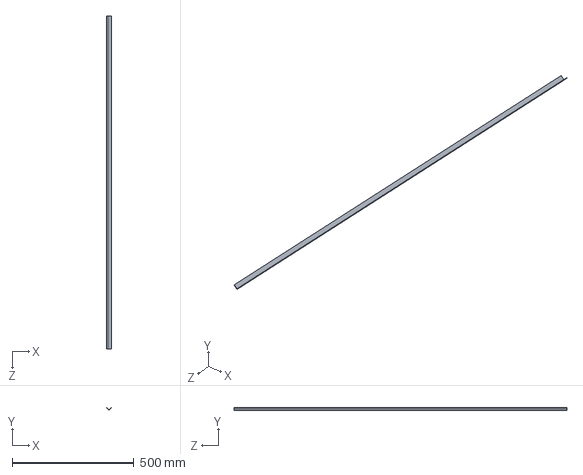
[picture p52: CAD file, 2022-10-29]
CAD UPDATE 10-17/AngleAluminum.SLDPRT
19.8 x 10.8 x 1365.2 mm
