GingerGengar/Sizing_Algorithm/CAD UPDATE 10-17/Plastic Storage Box - 6 Quart.SLDPRT

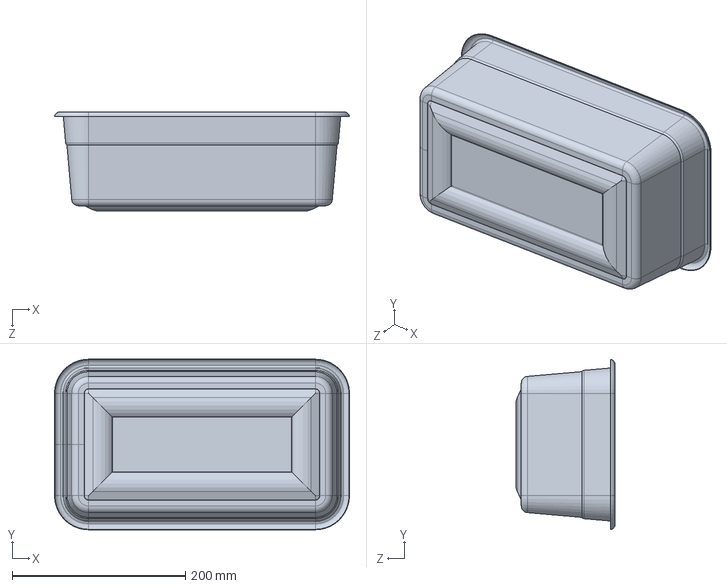
[picture p53: CAD file, 2022-10-29]
CAD UPDATE 10-17/Plastic Storage Box - 6 Quart.SLDPRT
340.3 x 196.8 x 114.8 mm
