GingerGengar/Sizing_Algorithm/CAD UPDATE 10-17/BetterWing.SLDPRT

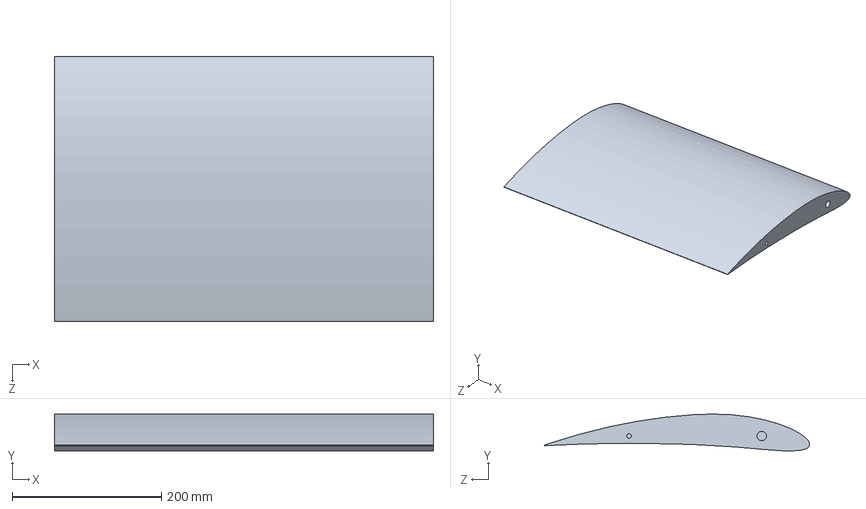
[picture p54: CAD file, 2022-10-29]
CAD UPDATE 10-17/BetterWing.SLDPRT
508.0 x 49.4 x 355.7 mm
