GingerGengar/Sizing_Algorithm/CAD UPDATE 10-17/NylonNut.SLDPRT

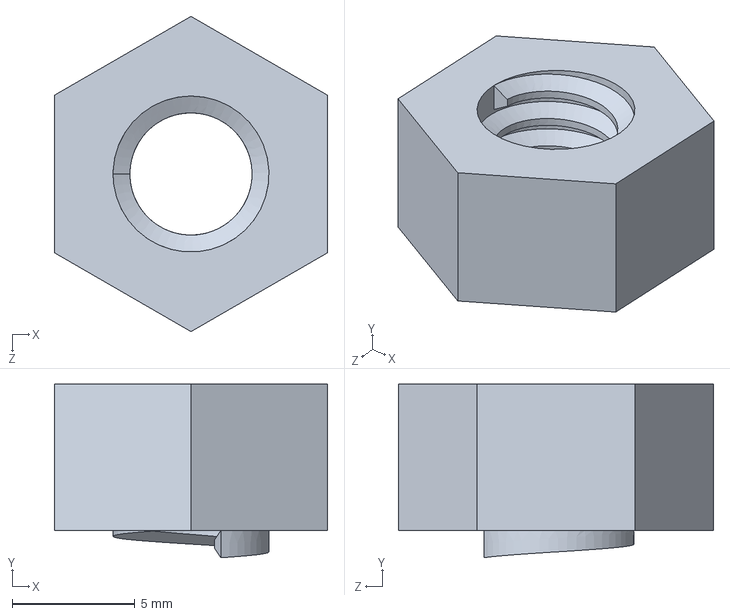
[picture p55: CAD file, 2022-10-29]
CAD UPDATE 10-17/NylonNut.SLDPRT
11.1 x 7.06 x 12.8 mm
