GingerGengar/Sizing_Algorithm/CAD UPDATE 10-17/CrazyNoze.SLDPRT

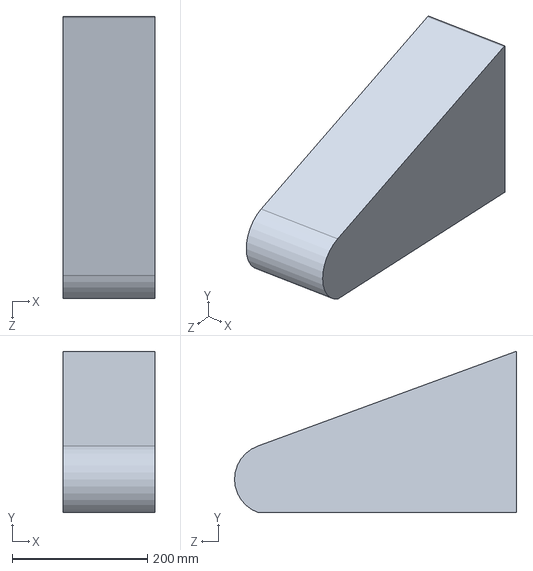
[picture p56: CAD file, 2022-10-29]
CAD UPDATE 10-17/CrazyNoze.SLDPRT
136.7 x 238.3 x 416.9 mm
