GingerGengar/Sizing_Algorithm/CAD UPDATE 10-17/FuselageWithWingShape.SLDPRT

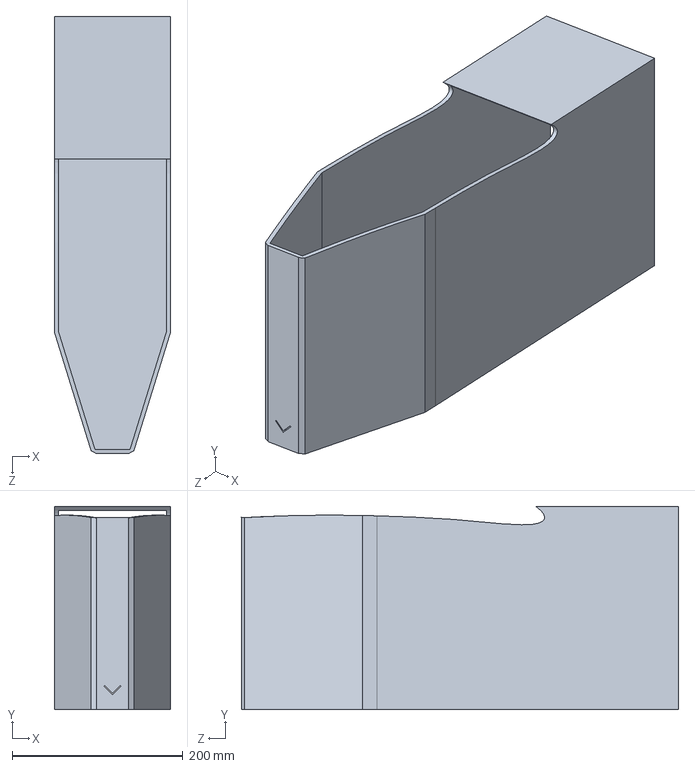
[picture p57: CAD file, 2022-10-26]
CAD UPDATE 10-17/FuselageWithWingShape.SLDPRT
136.5 x 238.1 x 512.8 mm
