GingerGengar/Sizing_Algorithm/CAD UPDATE 10-17/FuselageBottomPlate.SLDPRT

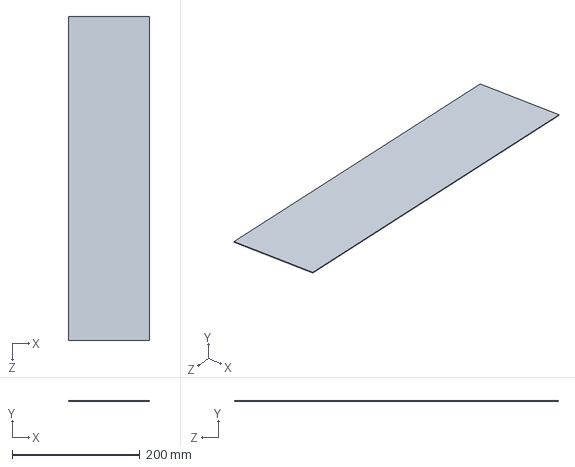
[picture p58: CAD file, 2022-10-26]
CAD UPDATE 10-17/FuselageBottomPlate.SLDPRT
127.0 x 1.00 x 508.0 mm
