GingerGengar/Sizing_Algorithm/CAD UPDATE 10-17/FuselageBackRibANGLE_NEW.SLDPRT

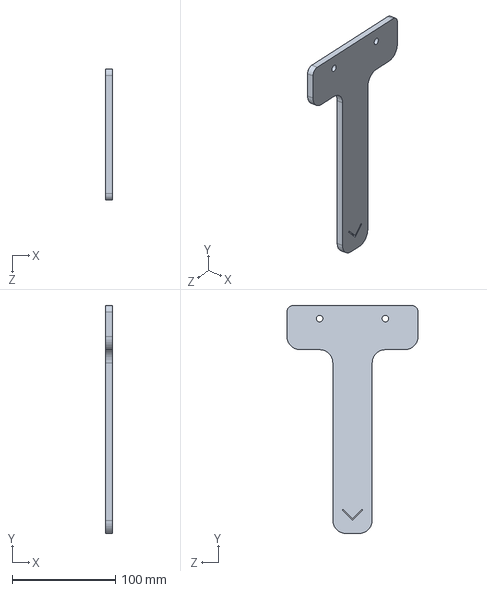
[picture p59: CAD file, 2022-10-26]
CAD UPDATE 10-17/FuselageBackRibANGLE_NEW.SLDPRT
6.35 x 220.5 x 127.0 mm
