GingerGengar/Sizing_Algorithm/CAD UPDATE 10-17/FuselageDowel.SLDPRT

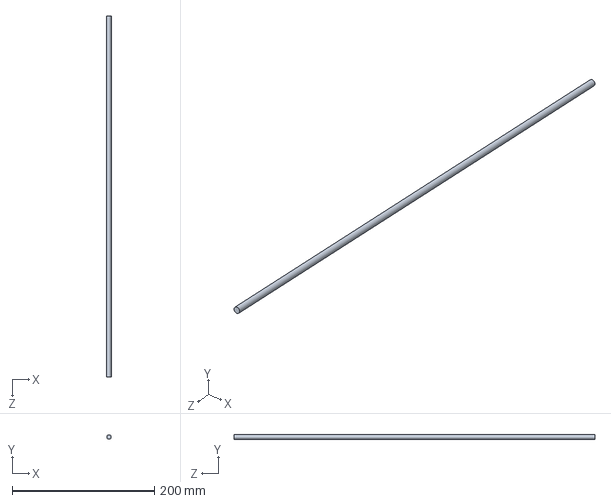
[picture p60: CAD file, 2022-10-26]
CAD UPDATE 10-17/FuselageDowel.SLDPRT
6.35 x 6.35 x 508.0 mm
