GingerGengar/Sizing_Algorithm/CAD UPDATE 10-17/MG995Servo.SLDPRT

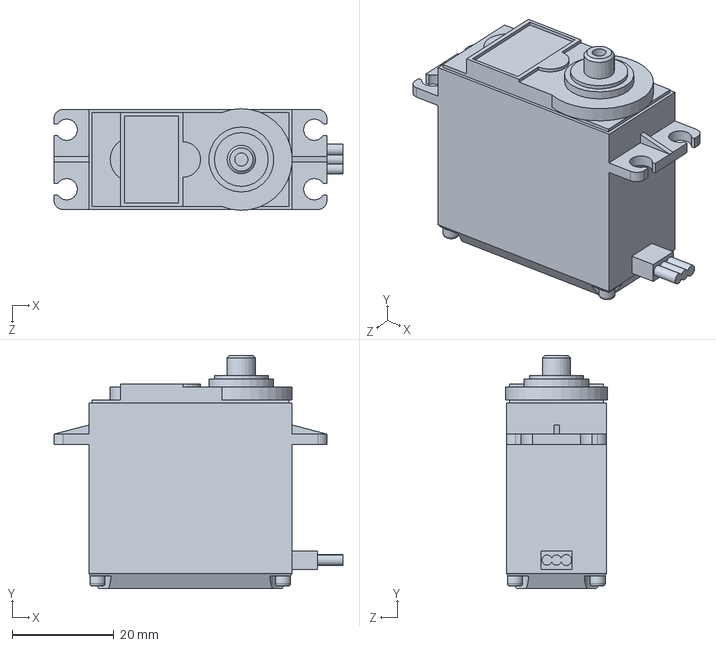
[picture p61: CAD file, 2022-10-18]
CAD UPDATE 10-17/MG995Servo.SLDPRT
56.8 x 45.9 x 20.0 mm
