GingerGengar/Sizing_Algorithm/CAD UPDATE 10-17/VerticalTailShell.SLDPRT

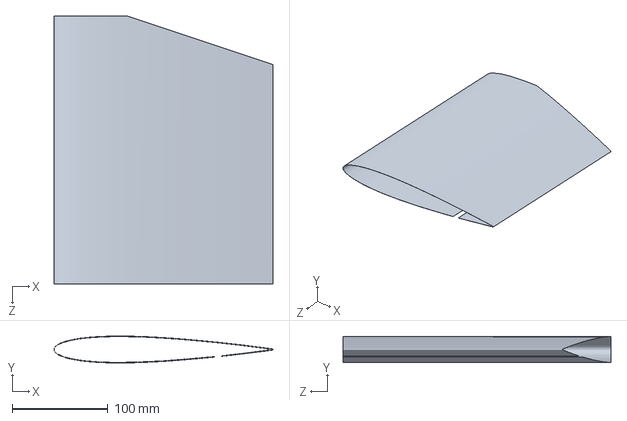
[picture p62: CAD file, 2022-10-18]
CAD UPDATE 10-17/VerticalTailShell.SLDPRT
228.8 x 27.6 x 279.9 mm
