GingerGengar/Sizing_Algorithm/CAD UPDATE 10-17/WingConnector.SLDPRT

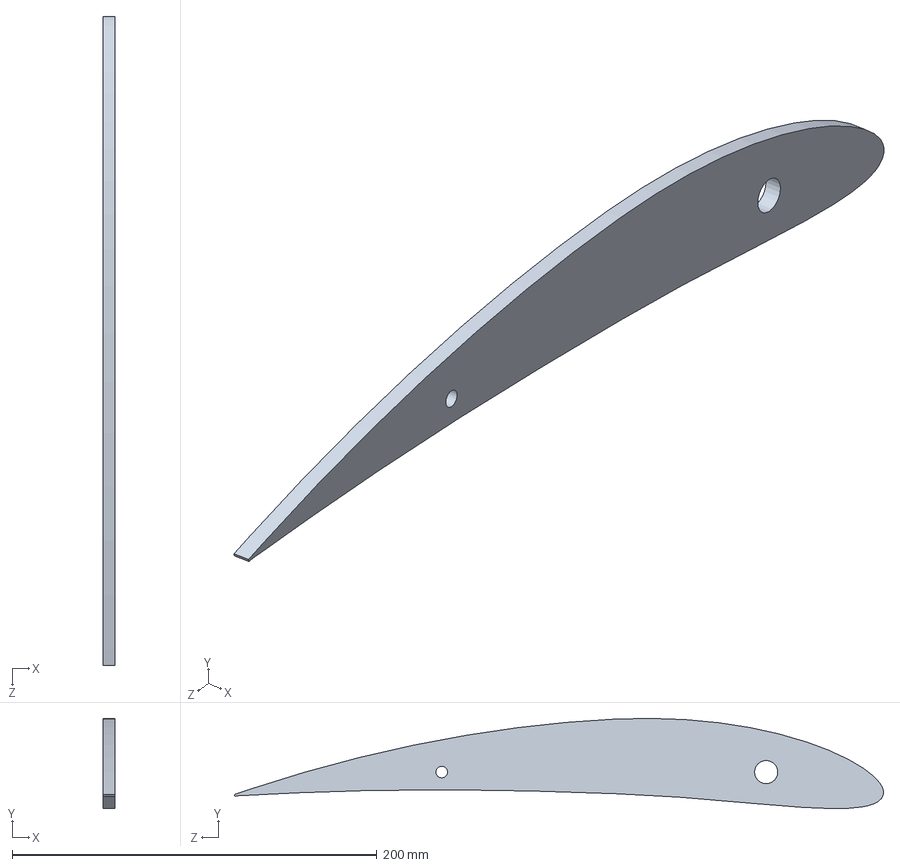
[picture p63: CAD file, 2022-10-18]
CAD UPDATE 10-17/WingConnector.SLDPRT
6.35 x 49.5 x 355.7 mm
