GingerGengar/Sizing_Algorithm/CAD UPDATE 10-17/WingInnerPart.SLDPRT

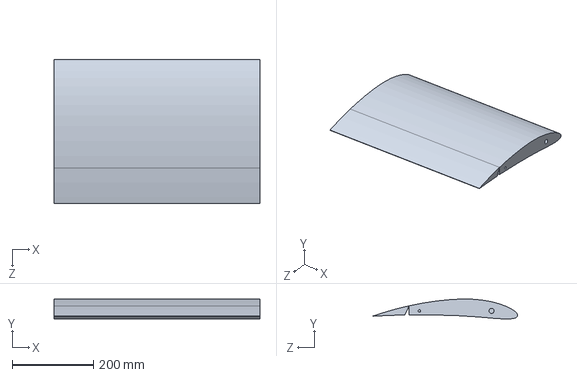
[picture p64: CAD file, 2022-10-18]
CAD UPDATE 10-17/WingInnerPart.SLDPRT
508.0 x 49.3 x 355.7 mm
