GingerGengar/Sizing_Algorithm/CAD UPDATE 10-17/Propellar.SLDPRT

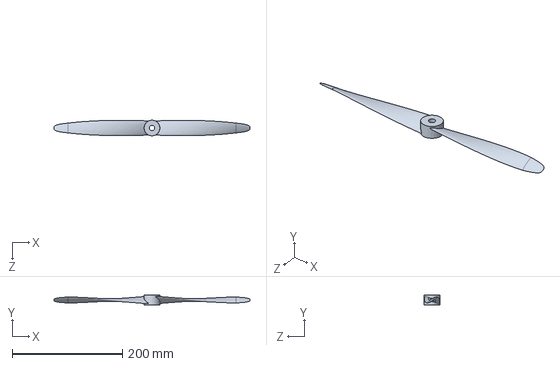
[picture p65: CAD file, 2022-10-18]
CAD UPDATE 10-17/Propellar.SLDPRT
355.6 x 17.3 x 28.7 mm
