GingerGengar/Sizing_Algorithm/CAD UPDATE 10-17/HorizontalTailShell.SLDPRT

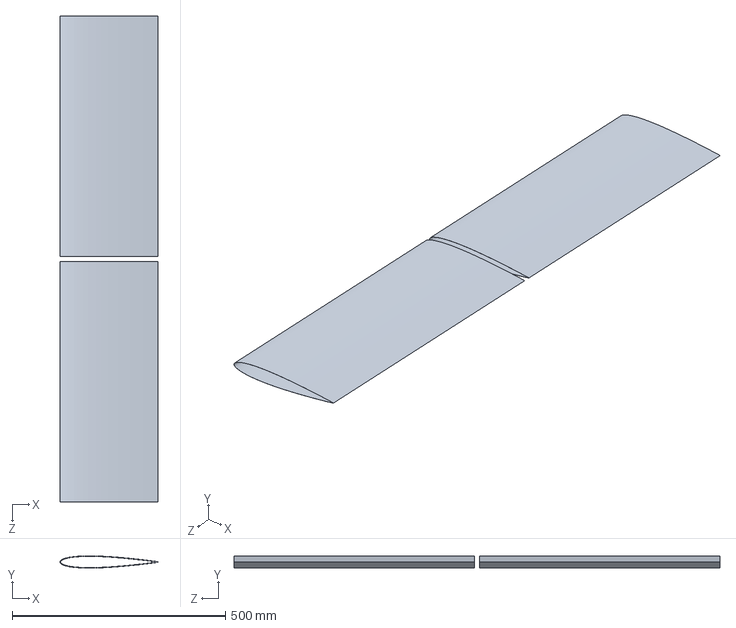
[picture p66: CAD file, 2022-10-18]
CAD UPDATE 10-17/HorizontalTailShell.SLDPRT
228.8 x 27.6 x 1140.0 mm
