GingerGengar/Sizing_Algorithm/CAD UPDATE 10-17/WingCenterShell.SLDPRT

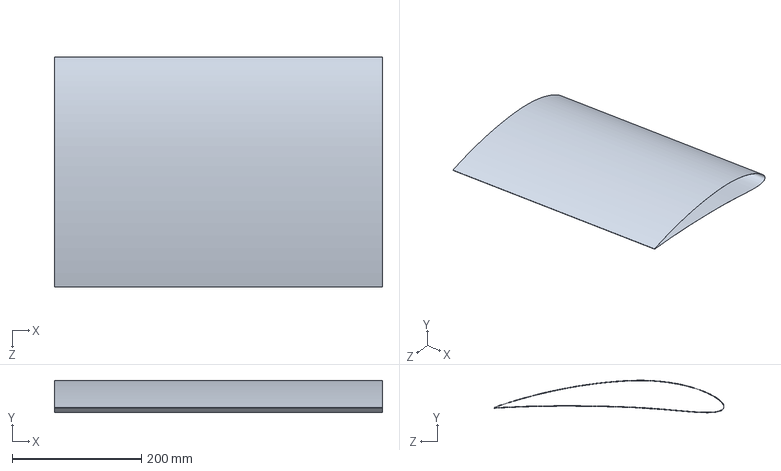
[picture p67: CAD file, 2022-10-18]
CAD UPDATE 10-17/WingCenterShell.SLDPRT
508.0 x 49.6 x 355.9 mm
