GingerGengar/Sizing_Algorithm/CAD UPDATE 10-17/WingCenter.SLDPRT

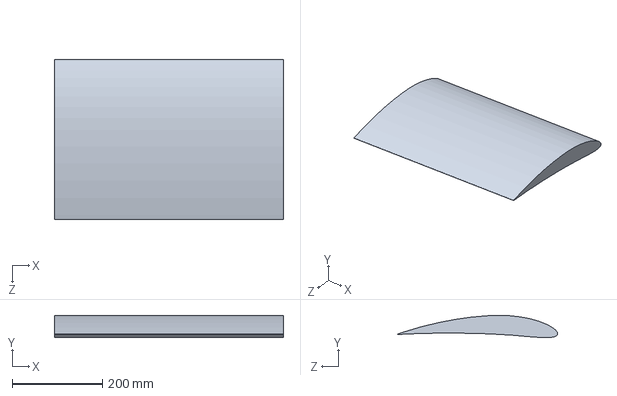
[picture p68: CAD file, 2022-10-18]
CAD UPDATE 10-17/WingCenter.SLDPRT
508.0 x 49.4 x 355.7 mm
