GingerGengar/Sizing_Algorithm/CAD UPDATE 10-17/Half_Inch_Spar.SLDPRT

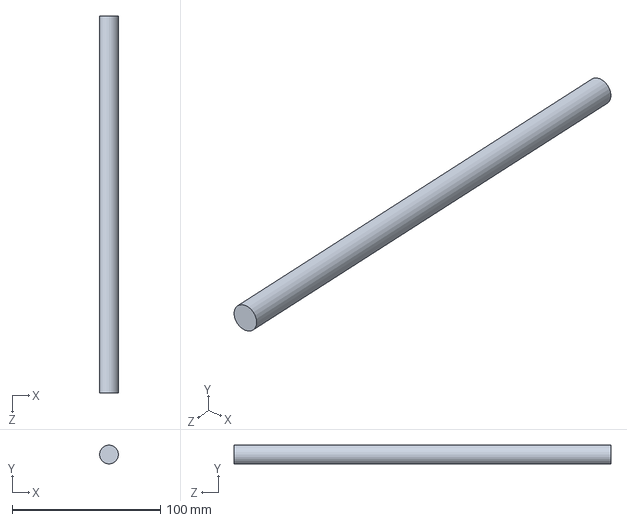
[picture p69: CAD file, 2022-10-18]
CAD UPDATE 10-17/Half_Inch_Spar.SLDPRT
12.7 x 12.7 x 254.0 mm
