GingerGengar/Sizing_Algorithm/CAD UPDATE 10-17/Half_Inch_Spar_CYLINDER_STL_.125_NEW.STL

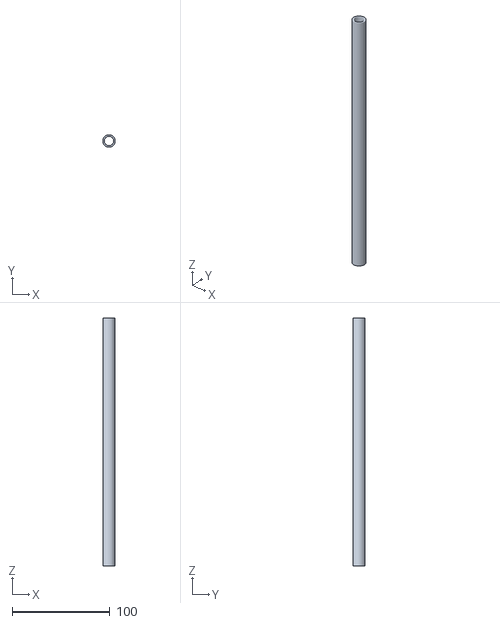
[picture p70: CAD file, 2022-10-18]
CAD UPDATE 10-17/Half_Inch_Spar_CYLINDER_STL_.125_NEW.STL
12.7 x 12.7 x 254.0
