GingerGengar/Sizing_Algorithm/CAD UPDATE 10-17/FuselageFrontRib.SLDPRT

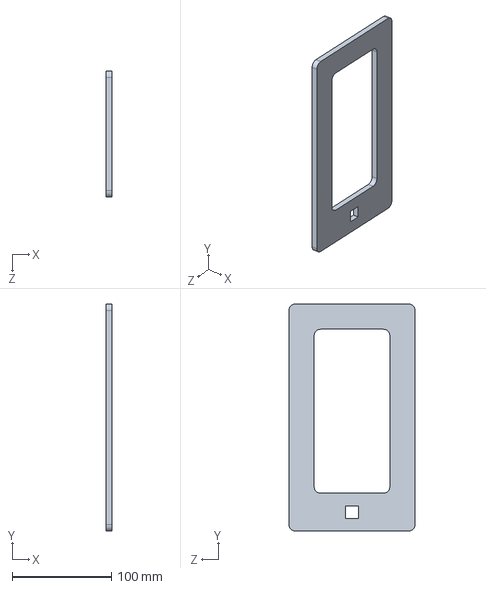
[picture p71: CAD file, 2022-10-17]
CAD UPDATE 10-17/FuselageFrontRib.SLDPRT
6.35 x 228.6 x 127.0 mm
