GingerGengar/Sizing_Algorithm/CAD UPDATE 10-17/SmallServo.SLDPRT

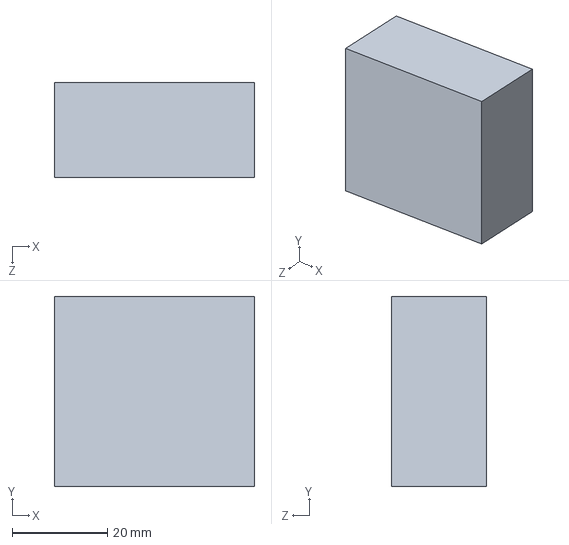
[picture p72: CAD file, 2022-10-17]
CAD UPDATE 10-17/SmallServo.SLDPRT
42.0 x 40.0 x 20.0 mm
