GingerGengar/Sizing_Algorithm/CAD UPDATE 10-17/WoodDowel.SLDPRT

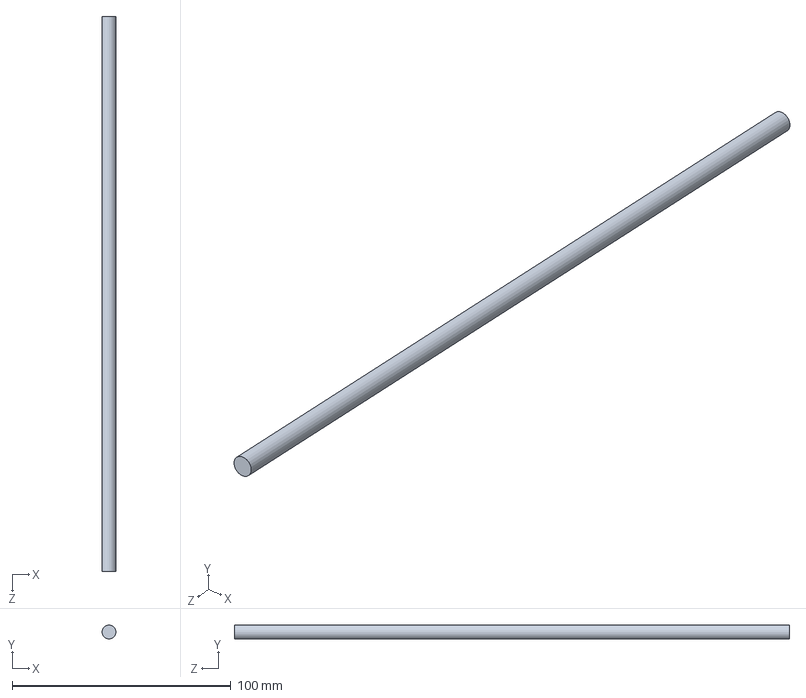
[picture p73: CAD file, 2022-10-17]
CAD UPDATE 10-17/WoodDowel.SLDPRT
6.35 x 6.35 x 254.0 mm
