GingerGengar/Sizing_Algorithm/CAD UPDATE 10-17/OnePieceWing.SLDPRT

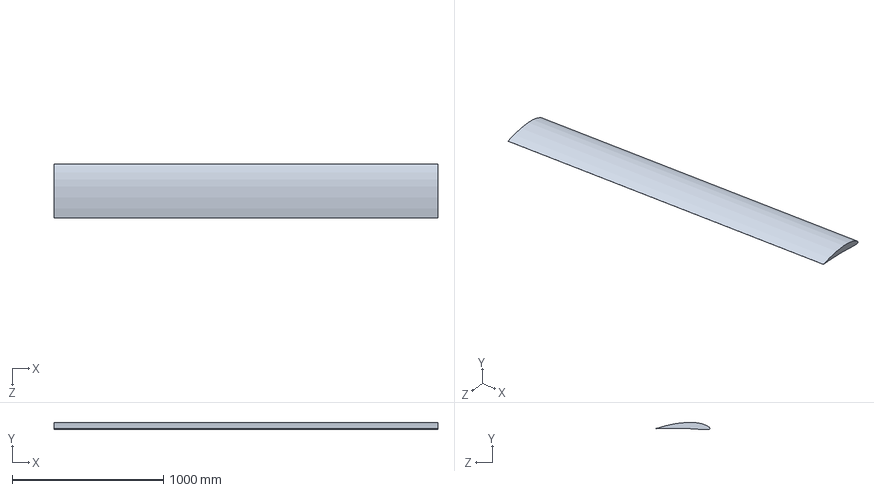
[picture p74: CAD file, 2022-10-17]
CAD UPDATE 10-17/OnePieceWing.SLDPRT
2540.0 x 48.8 x 355.7 mm
