GingerGengar/Sizing_Algorithm/CAD UPDATE 10-17/BigServo.SLDPRT

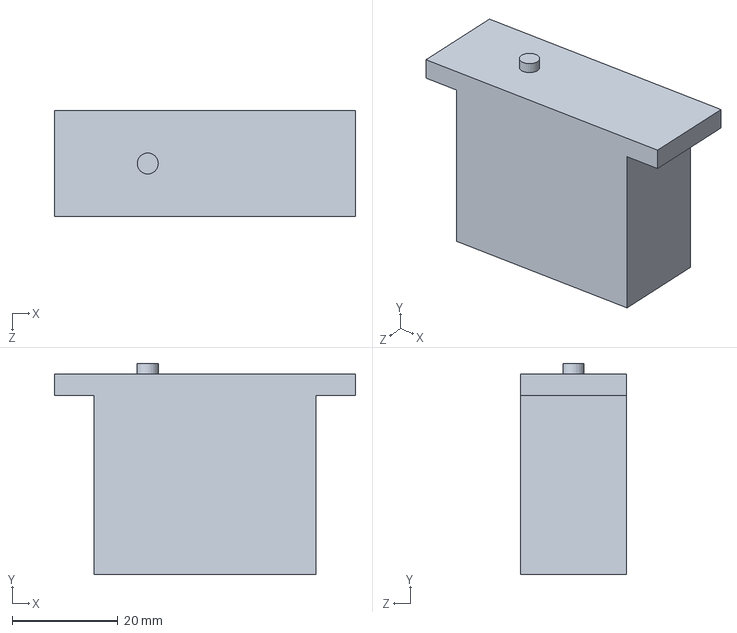
[picture p75: CAD file, 2022-10-17]
CAD UPDATE 10-17/BigServo.SLDPRT
57.0 x 40.0 x 20.0 mm
