GingerGengar/Sizing_Algorithm/CAD UPDATE 10-17/Pixhawk_4.SLDPRT

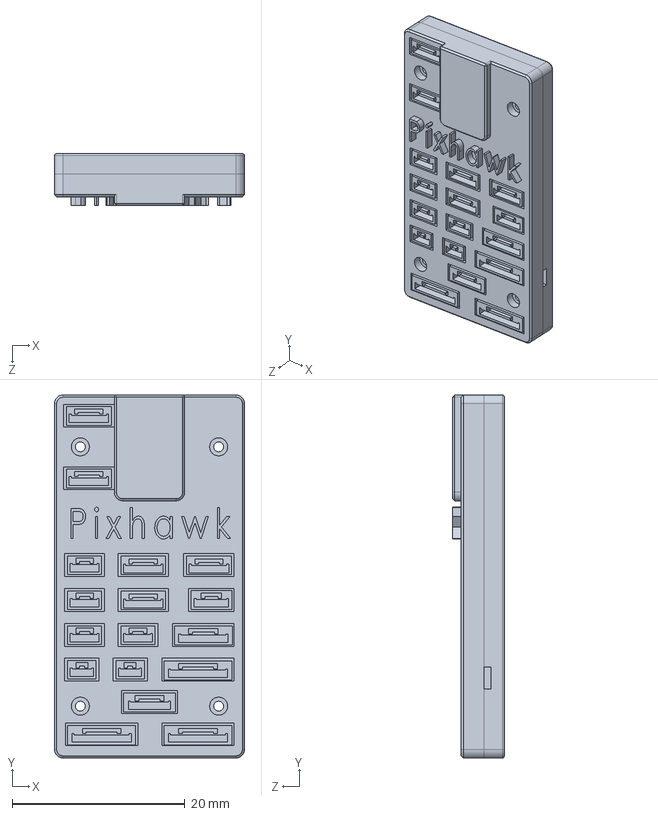
[picture p76: CAD file, 2022-10-04]
CAD UPDATE 10-17/Pixhawk_4.SLDPRT
22.0 x 42.0 x 6.00 mm
