GingerGengar/Sizing_Algorithm/CAD UPDATE 10-17/Wing V1.SLDPRT

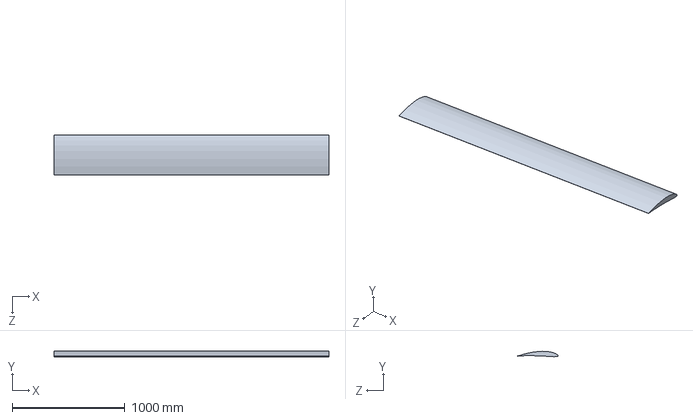
[picture p77: CAD file, 2022-10-04]
CAD UPDATE 10-17/Wing V1.SLDPRT
2438.4 x 48.9 x 356.3 mm
