GingerGengar/Sizing_Algorithm/CAD UPDATE 10-17/Rudder_FlatPlate_V1.SLDPRT

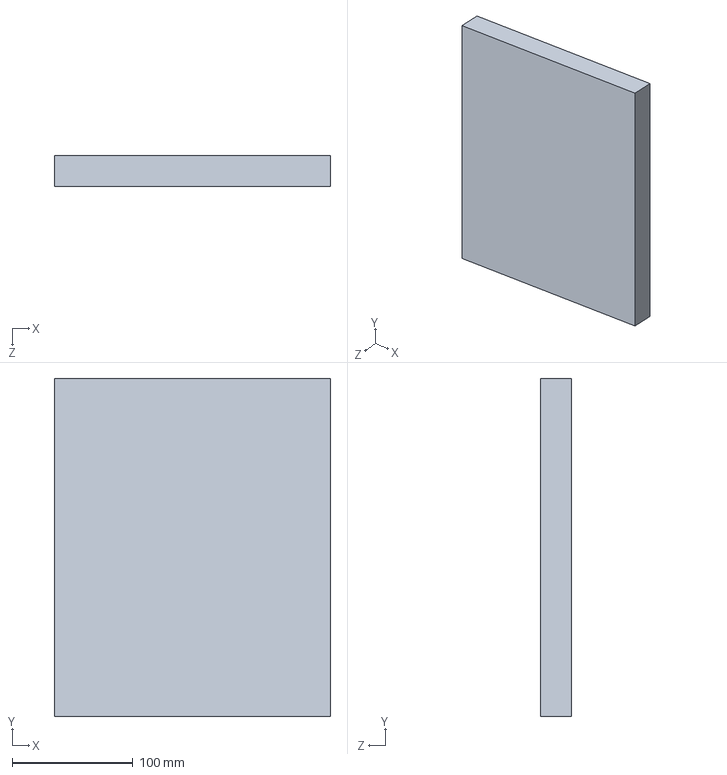
[picture p78: CAD file, 2022-10-04]
CAD UPDATE 10-17/Rudder_FlatPlate_V1.SLDPRT
228.6 x 279.9 x 25.4 mm
