GingerGengar/Sizing_Algorithm/CAD UPDATE 10-17/Stabilator_FlatPlate_V1.SLDPRT

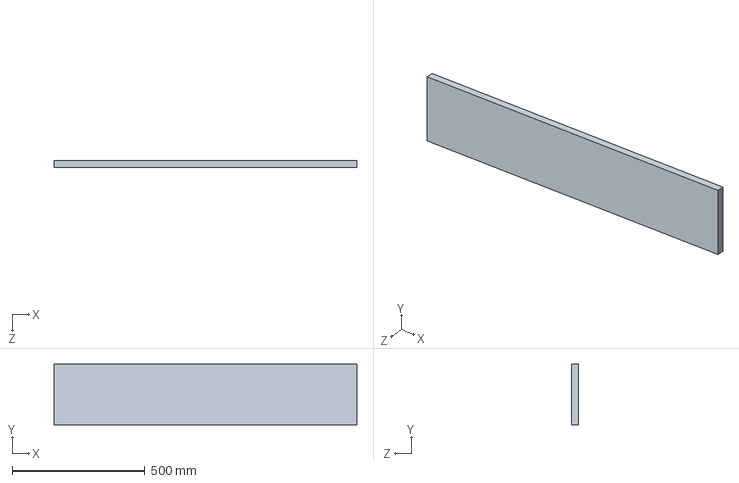
[picture p79: CAD file, 2022-10-04]
CAD UPDATE 10-17/Stabilator_FlatPlate_V1.SLDPRT
1140.0 x 228.6 x 25.4 mm
