GingerGengar/Sizing_Algorithm/CAD UPDATE 10-17/CF_Rod_V1.SLDPRT

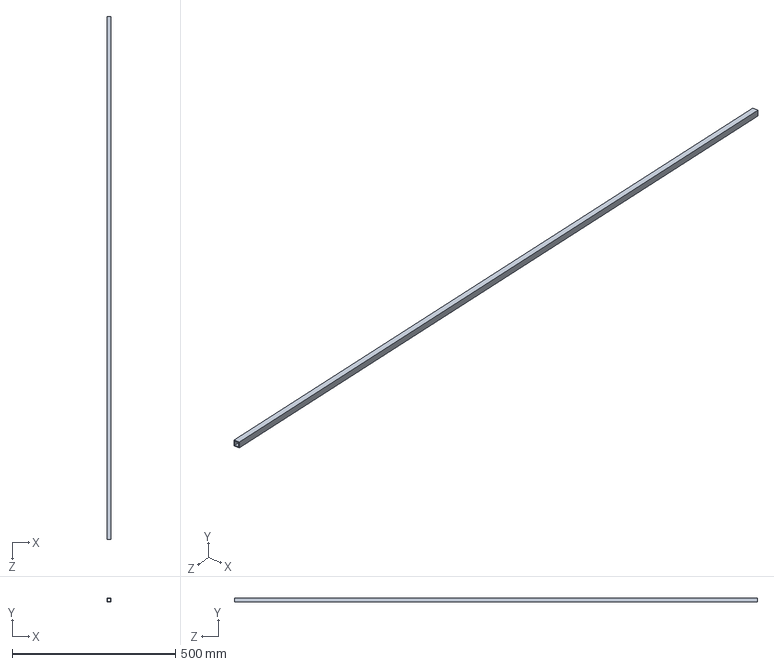
[picture p80: CAD file, 2022-10-04]
CAD UPDATE 10-17/CF_Rod_V1.SLDPRT
12.7 x 12.7 x 1600.0 mm
