GingerGengar/Sizing_Algorithm/CAD UPDATE 10-17/Prop_V1.SLDPRT

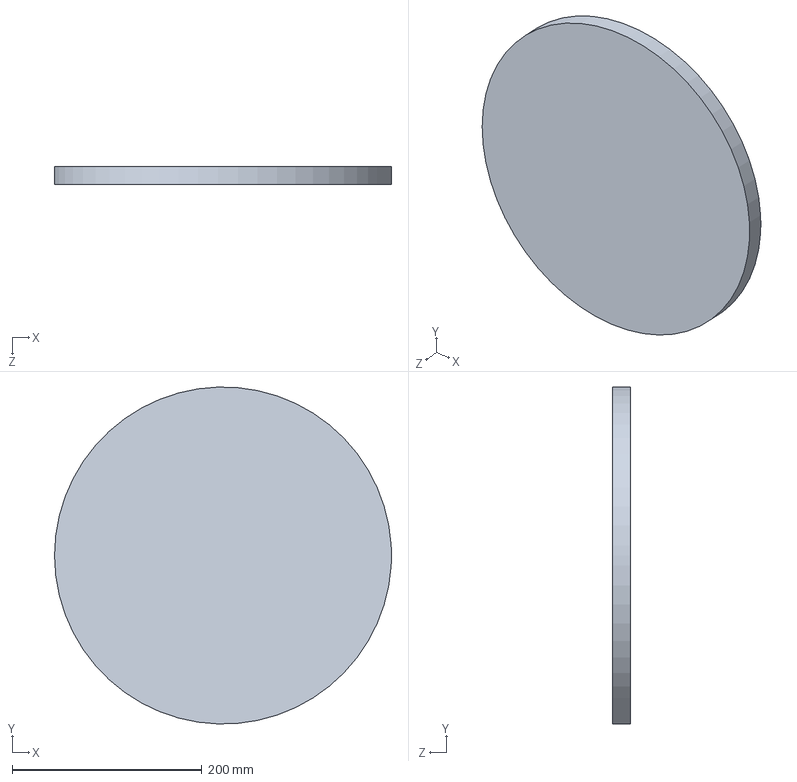
[picture p81: CAD file, 2022-10-04]
CAD UPDATE 10-17/Prop_V1.SLDPRT
355.6 x 355.4 x 19.1 mm
