GingerGengar/Sizing_Algorithm/CAD UPDATE 10-17/Big_Payload.SLDPRT

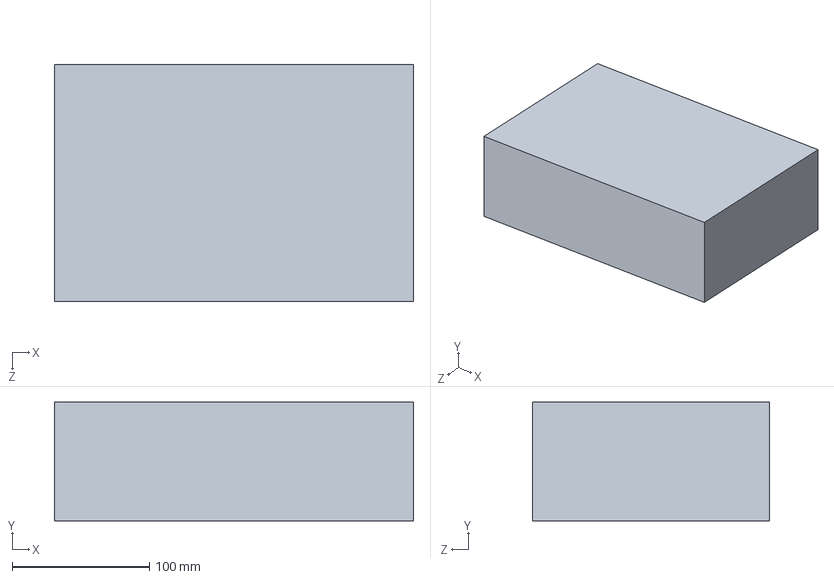
[picture p82: CAD file, 2022-10-04]
CAD UPDATE 10-17/Big_Payload.SLDPRT
261.6 x 86.4 x 172.7 mm
