GingerGengar/Sizing_Algorithm/CAD UPDATE 10-17/Fuselage_V1.SLDPRT

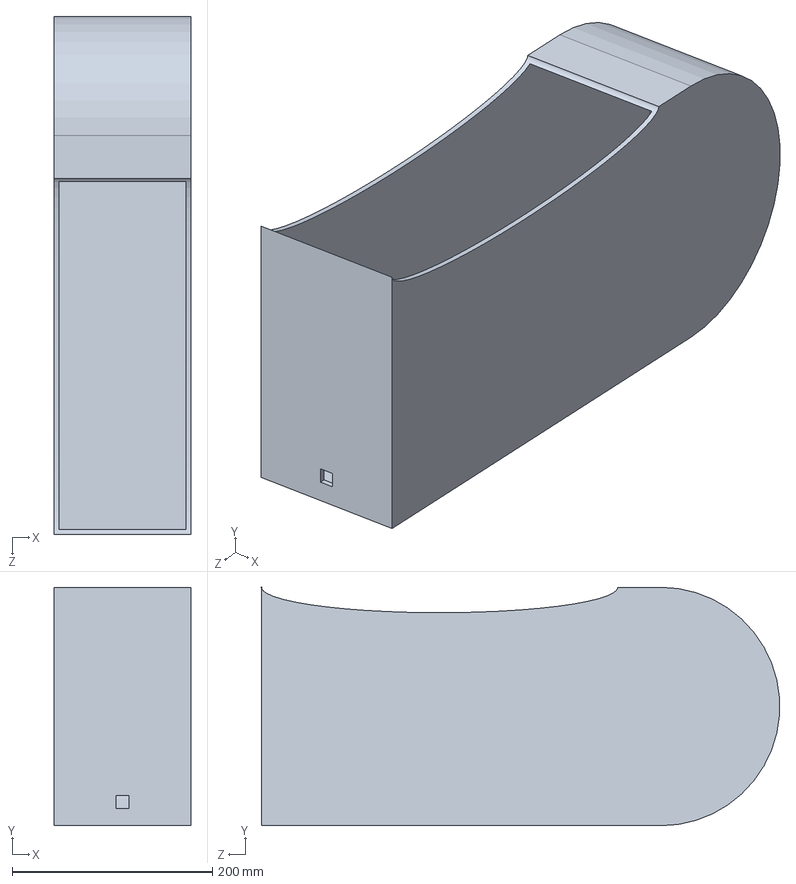
[picture p83: CAD file, 2022-10-04]
CAD UPDATE 10-17/Fuselage_V1.SLDPRT
136.5 x 238.1 x 517.2 mm
