GingerGengar/Sizing_Algorithm/CAD UPDATE 10-17/Small_Payload.SLDPRT

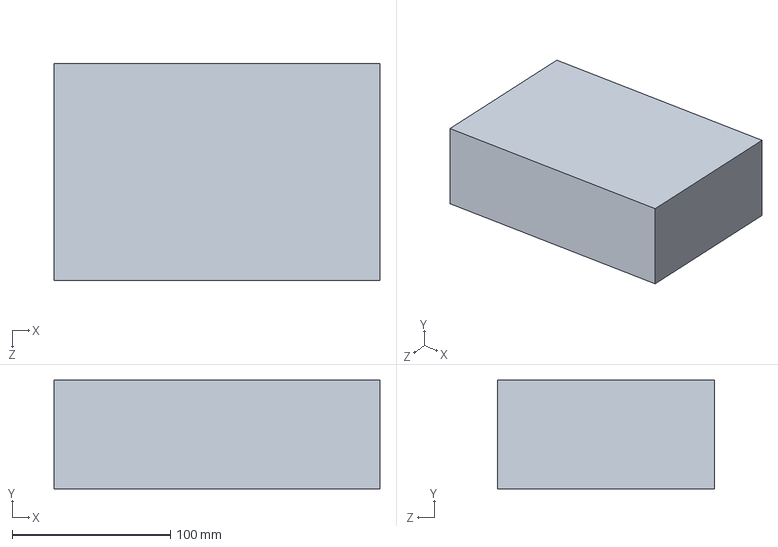
[picture p84: CAD file, 2022-10-03]
CAD UPDATE 10-17/Small_Payload.SLDPRT
205.7 x 68.6 x 137.2 mm
