GingerGengar/Sizing_Algorithm/(list of files, cad)

Other CAD files:
STL 10-27-22/FRONT_WING_MOUNT_NEW.STL
STL 10-27-22/Motor_Mount_NEW_THIN.STL
STL 11-3-22/TailAdapter.STL
STL 10-27-22/REAR HARDPOINT.STL
STL 11-3-22/BatteryESCMount.STL
CAD UPDATE 10-17/REAR HARDPOINT.SLDPRT
CAD UPDATE 10-17/BatteryESCMount.SLDPRT
CAD UPDATE 10-17/BoomStopper.SLDPRT
CAD UPDATE 10-17/TailAdapter.SLDPRT
CAD UPDATE 10-17/SmallPXMount.SLDPRT
CAD UPDATE 10-17/Half_Inch_Spar_CYLINDER_NEW.SLDPRT
CAD UPDATE 10-17/MG995ServoBig.SLDPRT
CAD UPDATE 10-17/WingOuterPartLeft.SLDPRT
CAD UPDATE 10-17/WingOuterPart.SLDPRT
CAD UPDATE 10-17/MotorMount.SLDPRT
CAD UPDATE 10-17/FuselageBackRib.SLDPRT
CAD DEPRECATED/AngleAluminum.SLDPRT
CAD DEPRECATED/Batt_V1.SLDPRT
CAD DEPRECATED/BetterAssembly.SLDASM
CAD DEPRECATED/BetterWing.SLDPRT
CAD DEPRECATED/FuselageBackRib.SLDPRT
CAD DEPRECATED/FuselageWithWingShape.SLDPRT
CAD DEPRECATED/HorizontalTail.SLDPRT
CAD DEPRECATED/HorizontalTailShell.SLDPRT
CAD DEPRECATED/MG995Servo.SLDPRT
CAD DEPRECATED/Motor.SLDPRT
CAD DEPRECATED/MotorMount.SLDPRT
CAD DEPRECATED/Motor_V1.SLDPRT
CAD DEPRECATED/Pixhawk_V1.SLDPRT
CAD DEPRECATED/Propellar.SLDPRT
CAD DEPRECATED/TailAdapter.SLDPRT
CAD DEPRECATED/VerticalTail.SLDPRT
CAD DEPRECATED/VerticalTailShell.SLDPRT
CAD DEPRECATED/WingCenter.SLDPRT
CAD DEPRECATED/WingCenterShell.SLDPRT
CAD DEPRECATED/WingConnector.SLDPRT
CAD DEPRECATED/WingInnerPart.SLDPRT
CAD DEPRECATED/WingOuterPart.SLDPRT
CAD DEPRECATED/WingOuterShell.SLDPRT
CAD UPDATE 10-17/AssemblyNoFiberglass.SLDASM
CAD UPDATE 10-17/BatteryESCMountOLD.SLDPRT
CAD UPDATE 10-17/BoomBolt.SLDPRT
CAD UPDATE 10-17/FuselageWithWingShape - Copy.SLDPRT
CAD UPDATE 10-17/Motor_Mount_OLD.SLDPRT
CAD UPDATE 10-17/Motor_V1.SLDPRT
CAD UPDATE 10-17/No 8 Pan Head Screw.SLDPRT
CAD UPDATE 10-17/NylonBolt.SLDPRT
CAD UPDATE 10-17/NylonBoltHex.SLDPRT
STL/FRONT_WING_MOUNT_NEW.STL
STL/Motor_Mount_NEW.STL
STL/REAR HARDPOINT.STL
