GingerGengar/Sizing_Algorithm/Wind_Tunnel_Testing/WIND TUNNEL TESTING.xlsx

Sheet: Scaled Stall Speed
v (m/s)= | 12.6999998 |  | chord (m)= | 0.128016 |  | span(m)= | 0.9144 |  | chord (AC) (m) = | 0.3556 | Span (AC) (m) = | 2.54
AOA rel(deg) | Drag(lbf) | Lift (lbf) | q (in of water) | q(Pa) | Drag(N) | Lift (N) | CL | Aircraft Lift (N) | Aircraft Lift (lb)
0 | 0.2160232147 | 1.217824736 | 0.3976731283 | 98.94902779 | 0.9609191341 | 5.41715432 | 0.4723914002 | 5.462808647 | 1.228088549
1 | 0.2006842485 | 1.383889313 | 0.3912577109 | 97.35274362 | 0.8926880131 | 6.155846363 | 0.5368074658 | 6.207726188 | 1.395552717
1 | 0.218256654 | 1.387175725 | 0.3937888557 | 97.98254308 | 0.9708539672 | 6.170465051 | 0.5380822574 | 6.222468079 | 1.398866826 |  | MAX CL | 0.8632539252
2 | 0.1951051216 | 1.520358114 | 0.3998779306 | 99.49762669 | 0.8678708199 | 6.762889832 | 0.5897433981 | 6.819885657 | 1.533171675 |  | Max AC Lift | 2.244224302
3 | 0.1788707676 | 1.751629549 | 0.3967338985 | 98.71532862 | 0.7956568154 | 7.791636432 | 0.6794530534 | 7.857302257 | 1.766392263
4 | 0.1279465624 | 1.795935052 | 0.4008887966 | 99.74915038 | 0.5691346651 | 7.988717125 | 0.6966390553 | 8.056043894 | 1.811071172
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
