GingerGengar/Sizing_Algorithm/(commit log)

2022-09-08 Completed the Bare theory for thrust to weight and Wing Loading
2022-09-09 Created the script to find wing loading and the thrust to weight ratio
2022-09-10 Completed the TW ratio and Wing Loading Scripts, need more thoughts on variable definitions
2022-09-10 Finished the Matlab implementations for TW and Wing Loading
2022-09-11 Structure sizing using wing mass
2022-09-12 Added capabilities to compute the battery mass/weight
2022-09-12 Everything works so far, there is a major problem though, the thrust prescribed for finding the battery size is the thrust required for a steep climb. Need to readjust thrust values.
2022-09-24 Prop sizing
2022-10-02 Uploaded cad
    [Assembly.SLDASM, Batt_V1.SLDPRT, Big_Payload.SLDPRT, Motor_V1.SLDPRT, Pixhawk_V1.SLDPRT, Prop_V1.SLDPRT, Small_Payload.SLDPRT, Wing V1.SLDPRT]
2022-10-03 Updated wings XFLR
2022-10-03 Added all CM vs Alpha trim values
    [trim1_5.csv, trim2_5.csv, trim3.csv, trim_0.csv, trim_neg_1_5.csv, trim_neg_3.csv]
2022-10-03 add fuselage components
    [CF_Rod_V1.SLDPRT, Fuselage_V1.SLDPRT]
2022-10-04 CAD update + assy
    [Assembly.SLDASM, CF_Rod_V1.SLDPRT, Fuselage_V1.SLDPRT, Rudder_FlatPlate_V1.SLDPRT, Stabilator_FlatPlate_V1.SLDPRT]
2022-10-04 updated assembly
    [Assembly.SLDASM, Fuselage_V1.SLDPRT, Motor_V1.SLDPRT, Prop_V1.SLDPRT, Wing V1.SLDPRT]
2022-10-04 Improved CAD
    [Assembly.SLDASM, Batt_V1.SLDPRT, BetterAssembly.SLDASM, BetterWing.SLDPRT, Big_Payload.SLDPRT, CF_Rod_V1.SLDPRT, FuselageWithWingShape.SLDPRT, HorizontalTail.SLDPRT]
2022-10-04 Move vertical tail
    [BetterAssembly.SLDASM]
2022-10-06 rotated airfoil file
    [Rotated_Airfoil.csv, WING_COORDS.csv]
2022-10-06 Ian's rotation code
    [Rotated_Airfoil.csv]
2022-10-16 Improved assembly
    [BetterAssembly.SLDASM, BetterWing.SLDPRT, BigServo.SLDPRT, FuselageBackRib.SLDPRT, FuselageFrontRib.SLDPRT, FuselageWithWingShape.SLDPRT, HorizontalTail.SLDPRT, MG995Servo.SLDPRT]
2022-10-17 CAD Improvements
    [AngleAluminum.SLDPRT, BetterAssembly.SLDASM, HorizontalTail.SLDPRT, HorizontalTailShell.SLDPRT, Motor.SLDPRT, MotorMount.SLDPRT, TailAdapter.SLDPRT, VerticalTailShell.SLDPRT]
2022-10-17 Create Wing_Graph_0_LIFT DISTRIBUTION.csv
    [Wing_Graph_0_LIFT DISTRIBUTION.csv]
2022-10-17 wing loading file from brightspace
2022-10-18 New CAD folder
    [AngleAluminum.SLDPRT, Assembly.SLDASM, Batt_V1.SLDPRT, BetterAssembly.SLDASM, BetterWing.SLDPRT, BigServo.SLDPRT, Big_Payload.SLDPRT, CF_Rod_V1.SLDPRT]
2022-10-18 Full CAD
    [BetterAssembly.SLDASM, BetterWing.SLDPRT, ESC.SLDPRT, FRONT_WING_MOUNT_NEW.SLDPRT, Half_Inch_Spar_CYLINDER_NEW.SLDPRT, HorizontalTailShell.SLDPRT, Motor.SLDPRT, Motor_Mount_NEW.SLDPRT]
2022-10-18 More STL
    [AngleAluminum.SLDPRT, BetterAssembly.SLDASM, FRONT_WING_MOUNT_NEW.SLDPRT, FuselageWithWingShape.SLDPRT, Half_Inch_Spar_CYLINDER_NEW.STL, REAR HARDPOINT.SLDPRT]
2022-10-18 Best CAD
    [BetterAssembly.SLDASM, Half_Inch_Spar_CYLINDER_NEW.SLDPRT, MG995Servo.SLDPRT, MG995ServoBig.SLDPRT]
2022-10-25 added battery usage code
2022-10-25 trim diagram
    [trim1_5.csv, trim2_5.csv, trim3.csv, trim_0.csv, trim_neg_1_5.csv, trim_neg_3.csv]
2022-10-25 Updated XLFR to match CAD
2022-10-25 Final CDR Changes
    [AngleAluminum.SLDPRT, AssemblyNoFiberglass.SLDASM, BetterAssembly.SLDASM, FRONT_WING_MOUNT_NEW.SLDPRT, FuselageBackRibANGLE_NEW.SLDPRT, FuselageBottomPlate.SLDPRT, FuselageDowel.SLDPRT, FuselageFrontRibANGLE_NEW.SLDPRT]
2022-10-25 CG changes
    [AngleAluminum.SLDPRT, AssemblyNoFiberglass.SLDASM, AssemblyNoFiberglass.STEP, HorizontalTail.SLDPRT, NoseCone.SLDPRT]
2022-10-26 Cleaned up Git and added wind tunnel tests
    [WIND TUNNEL TESTING.xlsx]
2022-10-26 Update WIND TUNNEL TESTING.xlsx
    [WIND TUNNEL TESTING.xlsx]
2022-10-26 FIXED WINDTUNNEL
    [WIND TUNNEL TESTING.xlsx]
2022-10-26 Updated q in wind tunnel testing
    [WIND TUNNEL TESTING.xlsx]
2022-10-26 fixed beam bending code
    [Wing_Graph_0_LIFT DISTRIBUTION.csv]
2022-10-28 updated code
    [Rotated_Airfoil.csv]
2022-10-28 Added Cm v Alpha Plots
    Design is referring to the selected deisgn trim angle
    [cma_trim_0.csv, cma_trim_neg_1.csv, cma_trim_neg_1_5_DESIGN.csv, cma_trim_neg_2.csv, cma_trim_neg_3.csv, cma_trim_pos_1.csv, cma_trim_pos_2.csv, cma_trim_pos_3.csv]
2022-10-28 coding for cdr lol
    [cma_trim_0.csv, cma_trim_neg_1.csv, cma_trim_neg_1_5_DESIGN.csv, cma_trim_neg_2.csv, cma_trim_neg_3.csv, cma_trim_pos_1.csv, cma_trim_pos_2.csv, cma_trim_pos_3.csv]
2022-10-28 More CAD fidelity
    [AngleAluminum.SLDPRT, AssemblyGoCrazy.SLDASM, AssemblyNoFiberglass.SLDASM, BetterWing.SLDPRT, CrazyNoze.SLDPRT, FRONT_WING_MOUNT_NEW.SLDPRT, FRONT_WING_MOUNT_NEW.STL, Half_Inch_Spar_CYLINDER_NEW.SLDPRT]
2022-10-29 More CAD
    [AssemblyNoFiberglass.SLDASM, Motor_Mount_NEW.SLDPRT, Motor_Mount_NEW.STL, Motor_Mount_NEW_THIN.STL, Motor_Mount_OLD.SLDPRT, NylonBoltHex.SLDPRT, Plastic Storage Box - 6 Quart.SLDPRT, StorageBin.SLDPRT]
2022-11-01 Update battery usage plot with updated amps/times
2022-11-02 New wings
2022-11-04 Tolerance Changes for 3DP Parts
    [AssemblyNoFiberglass.SLDASM, BatteryESCMount.SLDPRT, BatteryESCMount.STL, BatteryRemoval.SLDASM, BoomStopper.SLDPRT, BoomStopper.STL, FRONT_WING_MOUNT_NEW.SLDPRT, FRONT_WING_MOUNT_NEW.STL]
2022-12-03 the last push
    [cm_trimmed_4_nopay.csv, cma_trim_4_5.csv]
